sad-zz/Intelligent-Vehicle-Traffic-Monitoring-System/راهنمای ترددشمار مرداد 97.pdf

## دستورالعمل بهرهبرداري و پشتيباني

## از دستگاههاي ترددشمار رهسام

رهرو سامانه آسيا

تابستان 1397

سلام

همكار گرامي، دستورالعمل پيش رو، جهت پشتيباني از دستگاههاي ترددشمار تنظيم شده است. پس از مطالعه

دقيق اين دستورالعمل، شما ميتوانيد مشكلات احتمالي سيستم ترددشماري را - در صورتيكه مشكل داخلي

دستگاه وجود نداشته باشد- تشخيص داده و برطرف نماييد. همچنين ميتوانيد جهت بازديد و شمارش بصري

ترددشمار حضور پيدا كرده و شمارش بصري را انجام دهيد.

در صورتيكه پس از بازديد دستگاه، كليه موارد مطروحه در اين دفترچه را بررسي نموده و مشكل را تشخيص نداديد، ميتوانيد با شماره تلفن 09123701598 آقاي مهندس جليلوند تماس بگيريد.

پيش از شروع كار، لطفا به اين نكات توجه داشته باشيد.

-1 حتما پس از بازديد از هر دستگاه، گزارش كامل عملكرد خود و نتيجه را به صورت كتبي يا شفاهي با شركت در ميان بگذاريد.
-2 حتما به نكات و هشدارهاي تأكيد شده در اين دستورالعمل دقت كنيد و در صورتيكه در مورد موضوعي

ترديد داريد، به صورت تلفني مسئله را با آقاي مهندس جليلوند مطرح كنيد. مسئوليت دستگاه در حين

بازديد و سركشي به عهده شماست. در صورتيكه به علت عدم توجه به نكات اين دستورالعمل مشكلي براي سيستم به وجود بيايد، مسئوليت كامل مشكل به عهده شما خواهد بود. -3 از رانندگي هنگام خواب آلودگي و خستگي جدا پرهيز نماييد و با احتياط و ايمني كامل برانيد.

پيشاپيش از زحمات شما سپاسگزاريم.

معرفي دستگاه ترددشمار رهسام

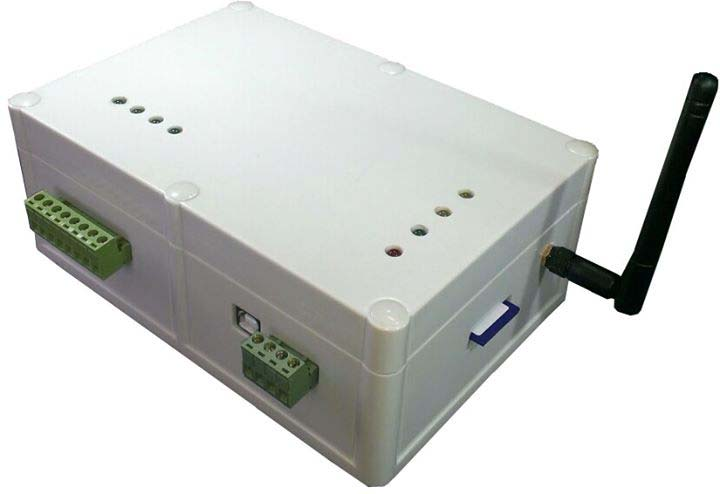
[picture p1: figure]

دستگاه ترددشمار رهسام به صورت يكپارچه (one in all (به توليد ميرسد كه يك دستگاه شامل سنسورهاي

اندازهگيري (آنالوگ و ديجيتال)، مودم و تجهيزات ارسال اطلاعات، كنترلر ولتاژ و... ميباشد.

هر دستگاه با يك شماره سريال 8 رقمي و يك عدد 3 رقمي براي نوع دستگاه مشخص ميگردد. مانند 10000052 براي سريال و 473 براي نوع دستگاه.

كد سريال روي دستگاه و كد نوع پشت دستگاه مشخص ميشود.

برچسب گارانتي رهسام (نقرهاي رنگ) به هيچ عنوان نبايد مخدوش شود!

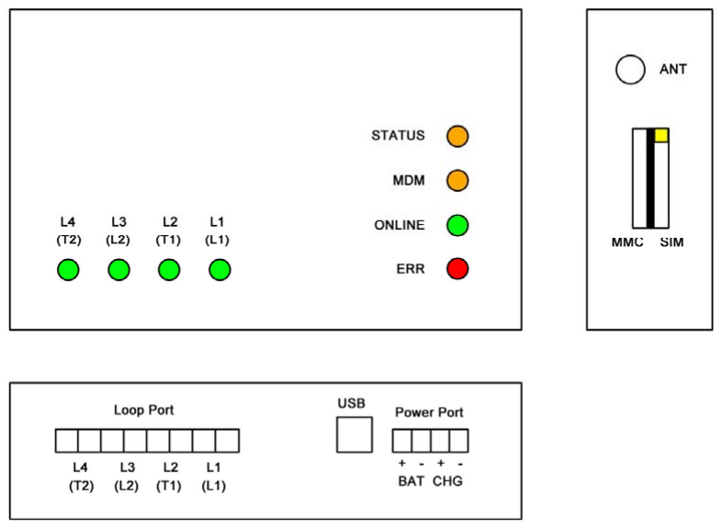
[picture p2: figure]

هر دستگاه از چهار حلقهي القايي (لوپ سنسور) و در نتيجه دو خط عبوري پشتيباني ميكند. دستگاه به صورت كلي شامل:

(Loop Port) | لوپها | پورت | •
(Power Port) | تغذيه | پورت | •
- پورت اتصال به كامپيوتر (USB(
- پورت آنتن (ANT(
- سوكت كارت حافظه (Card Memory(
- سوكت سيم كارت
LED | چراغهاي | •

ميباشد.

- پورت لوپها (Port Loop(: توسط يك سوكت فونيكس 8 پين، اتصال سيم لوپها به دستگاه برقرار

ميشود. به كمك سوكت فونيكس جهت تعويض دستگاه نيازي به باز كردن سيمها نيست و سوكت به صورت فشاري و كششي جدا ميشود. جهت اتصال سيمها به فونيكس، به يك پيچگوشتي دو سو ريز نياز است.

سيمهاي ورودي به سوكت فونيكس لوپها به اين ترتيب است:

از راست به چپ: لوپ 1 (1L – (لوپ 2 (1T – (لوپ 3 (2L – (لوپ 4 (2T (

- پورت تغذيه (Port Power(: منبع تغذيه، توسط يك سوكت فونيكس 4 پين به دستگاه متصل

ميشود.

سيمهاي ورودي به سوكت فونيكس تغذيه از راست به چپ به اين ترتيب است:

منفي شارژر – مثبت شارژر – منفي باتري – مثبت باتري

ورودي پورت تغذيه در برابر اتصال اشتباه حفاظت نشده است. قبل از اتصال فونيكس به دستگاه، حتما از صحت سيمهاي ورودي مطمئن شويد!

- پورت اتصال به كامپيوتر (USB(: از پورت USB جهت مشاهدهي عملكرد دستگاه (شمارش بصري)

و اعمال و تغيير تنظيمات استفاده ميگردد. بدين منظور به يك كابل USB نوع B) اصطلاحا كابل

پرينتر) نياز است. نحوهي كار با نرمافزار و كدهاي دستوري مورد استفاده در بخش مربوط توضيح داده شده است.
- پورت آنتن (ANT(: آنتن مودم داخلي دستگاه توسط سوكت Ω 50SMA به دستگاه متصل ميشود.

در برخي از سايتهاي ترددشماري، احتمالا نياز به رابط افزايش طول آنتن (كانكتور آنتن) جهت بهبود آنتندهي ميباشد.
- سوكت كارت حافظه (Card Memory(: جهت ذخيرهي كليهي اطلاعات عبوري از جمله اطلاعات

تجمعي و تك به تك خودروها، يك مموري كارت با فرمت 32FAT استفاده شده است. ظرفيت اين كارت حداكثر GB32 ميباشد و بايستي قبل از اتصال به دستگاه، آماده (فولدر بندي) شده باشد.

- سوكت سيمكارت: سيمكارت در داخل يك قطعه پلاستيكي (خشاب سيم كارت) قرار گرفته و به

صورت كشويي داخل سوكت قرار ميگيرد. پين كد سيمكارت قبل از قرار دادن در دستگاه بايستي غير فعال گردد.

مطمئن شويد خشاب سيمكارت در شيارهاي كناري به درستي قرار گرفته باشد. در غير اينصورت احتمال افتادن سيمكارت و خشاب به داخل دستگاه وجود دارد!

- چراغهاي LED: 8 عدد چراغ ال اي دي داخل دستگاه تعبيه گشته كه چهار عدد مربوط به عملكرد

لوپها (تريگر) و چهار عدد نشاندهندهي وضعيت عملكرد دستگاه ميباشد. در بخش عيبيابي، روشهاي عيب يابي هر قسمت به طور تفصيلي توضيح داده شده است.
a. چراغ 1L تا 4L: در صورت حضور خودرو روي هر لوپ، چراغ مربوط به لوپ روشن شده و در

صورت عدم حضور خودرو خاموش ميشود. در غير اينصورت عملكرد لوپها، سيمهاي ارتباطي
و يا دستگاه مشكل دارد.
b. چراغ STATUS: زماني كه دستگاه روشن ميشود حدود 4 ثانيه روشن شده و پس از آن يك ثانيه روشن – يك ثانيه خاموش ميباشد. در غير اينصورت عملكرد دستگاه مشكل دارد.
c. چراغ MDM: اين چراغ نمايشگر وضعيت مودم است. هنگام روشن شدن شدن دستگاه، پس

از چند ثانيه روشن شده، هنگام رجيستر شدن سيمكارت به صورت 800 ميلي ثانيه خاموش و 64 ميلي ثانيه روشن (چشمك سريع)؛ و هنگام عملكرد عادي حدود 3 ثانيه خاموش 64 ميلي ثانيه روشن (چشمك آرام) ميشود. در غير اينصورت، وضعيت آنتندهي، سيمكارت و يا

عملكرد دستگاه مشكل دارد.
d. چراغ ONLINE: هنگامي كه دستگاه به سرور متصل باشد روشن، و در غير اينصورت خاموش

است. معمولا حدود 15 تا 20 ثانيه بعد از شروع چشمك آرام، بايستي روشن شود و خاموشي

چراغ نبايد بيشتر از 1 دقيقه باشد.
e. چراغ ERR: در صورتيكه مموري كارت مشكل داشته باشد، يك ثانيه روشن و يك ثانيه

خاموش است و در عملكرد عادي دستگاه، بايستي دائم خاموش باشد.

راهنماي راهاندازي و تعمير دستگاه

قبل از هرگونه تغيير در سختافزار (برق، سيمكارت، كارت حافظه، لوپها و... حتما برق دستگاه را قطع كنيد!

.1 نحوهي اتصال تغذيه

دستگاه ترددشمار رهسام از چهار حالت منبع تغذيه پشتيباني ميكند:

- پنلهاي خورشيدي: در اين حالت، دو سيم سلول خورشيدي به شارژر و دو سيم باتري به قسمت

باتري متصل ميگردد.

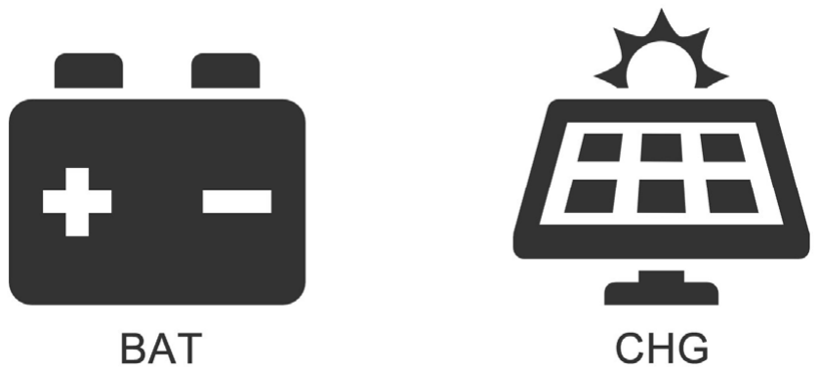
[picture p3: figure]

- برق شبانه (روشنايي جادهاي): در اين حالت، دو سيم آداپتور 24 ولت به قسمت شارژر و دو سيم

باتري به قسمت باتري متصل ميگردد.

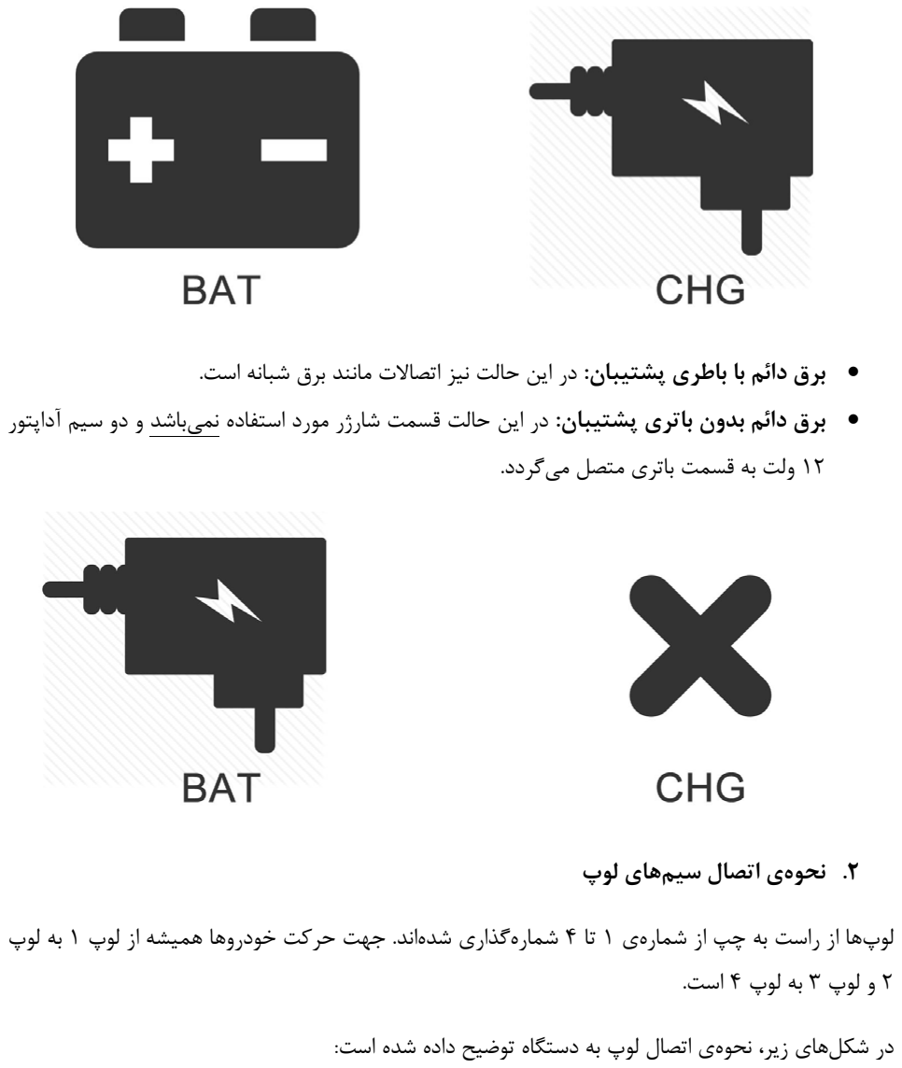
[picture p4: page 8]

- برق دائم با باطري پشتيبان: در اين حالت نيز اتصالات مانند برق شبانه است.
- برق دائم بدون باتري پشتيبان: در اين حالت قسمت شارژر مورد استفاده نميباشد و دو سيم آداپتور

12 ولت به قسمت باتري متصل ميگردد.

.2 نحوهي اتصال سيمهاي لوپ

لوپها از راست به چپ از شمارهي 1 تا 4 شمارهگذاري شدهاند. جهت حركت خودروها هميشه از لوپ 1 به لوپ 2 و لوپ 3 به لوپ 4 است.

در شكلهاي زير، نحوهي اتصال لوپ به دستگاه توضيح داده شده است:

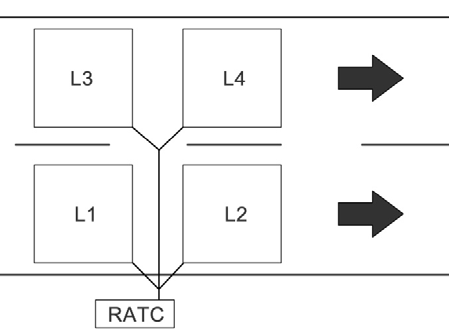
[picture p5: figure]
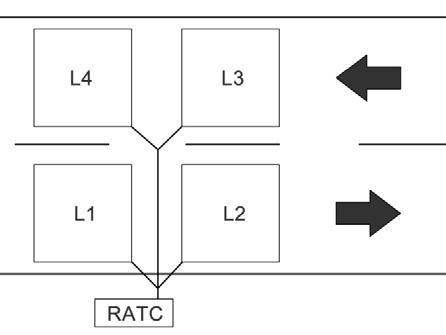
[picture p6: figure]

.3 نحوهي تعويض مموري كارت و استخراج اطلاعات آفلاين

سوكت مموري كارت، به صورت فشاري – دكمهاي است؛ هنگاميكه به داخل فشار داده شده و رها شود بيرون

ميآيد و براي جا زدن نيز هنگامي كه تا انتها وارد شده و آزاد شود، قفل ميگردد.

در داخل مموري كارت دو پوشه (فولدر) INT و TS بايد موجود باشد و داخل هر پوشه، دوازده پوشه به نامهاي 01 تا 12 تعبيه شده است.

جهت استخراج فايلهاي آفلاين كليه اطلاعات داخل مموري كارت را در كامپيوتر در يك پوشه به نام محور دستگاه (براي مثال karaj‐Tehran (كپي كرده و مموري كارت را در جاي خود قرار دهيد.

.4 نحوهي تعويض سيمكارت

خشاب سيمكارت، با فشار كليد زرد رنگ كنار سوكت از سوكت خارج ميشود. سيمكارت را از خشاب خارج كنيد و سيمكارت جديد را به خوبي داخل خشاب قرار دهيد، به طوريكه كاملا با لبههاي خشاب هم سطح شود.

سپس هنگام قراردادن خشاب داخل سوكت دقت كنيد لبههاي خشاب به درستي در شيارهاي سوكت قرار بگيرند. در غير اين صورت احتمال افتادن سيم كارت و خشاب به داخل دستگاه وجود دارد.

.5 نحوهي تعويض آنتن

آنتن و كانكتور آنتن، به صورت پيچي به دستگاه متصل ميشود. سفت كردن پيچهاي آنتن و كانكتور با دست كافيست و نيازي به استفاده از آچار، دم باريك و ... نميباشد.

.6 نحوهي تست اهمي لوپها

هر لوپ شامل دو سيم است و در هر سايت به تعداد چهار برابر خطوط عبوري سيم وجود دارد كه دو به دو به يكديگر اتصال دارند.

مقاومت اتصال دو سيم لوپ به يكديگر از كنار آسفالت تا ورود به دستگاه هيچگاه نبايد از 30 اهم بيشتر شود و

بوق اهممتر، بايد يكسره وصل باشد.

همچنين مقاومت بين سيمهاي لوپهاي مجزا، از كنار آسفالت تا ورود به دستگاه هيچگاه نبايد از 1 كيلو اهم

كمتر باشد.

اتصال به كامپيوتر

هيچ كدي را بدون هماهنگي وارد دستگاه نكنيد!

ابتدا درايورهاي مربوط به USB را (exe.Certified WHQL 2.12.04 v CDM (به روي سيستم نصب نماييد. سپس با اتصال كابل USB، سيستم به صورت خودكار شروع به نصب درايورهاي دستگاه مينمايد.

پس از اتمام نصب درايورها، يك پورت COM ايجاد ميشود كه از طريق اين پورت ميتوان به دستگاه متصل

شد.

نرمافزار پيشنهادي براي ارتباط با پورت COM، Terminal Hyper است؛ با شروع نرم افزار، يك نام دلخواه در نظر گرفته و سپس OK كنيد.

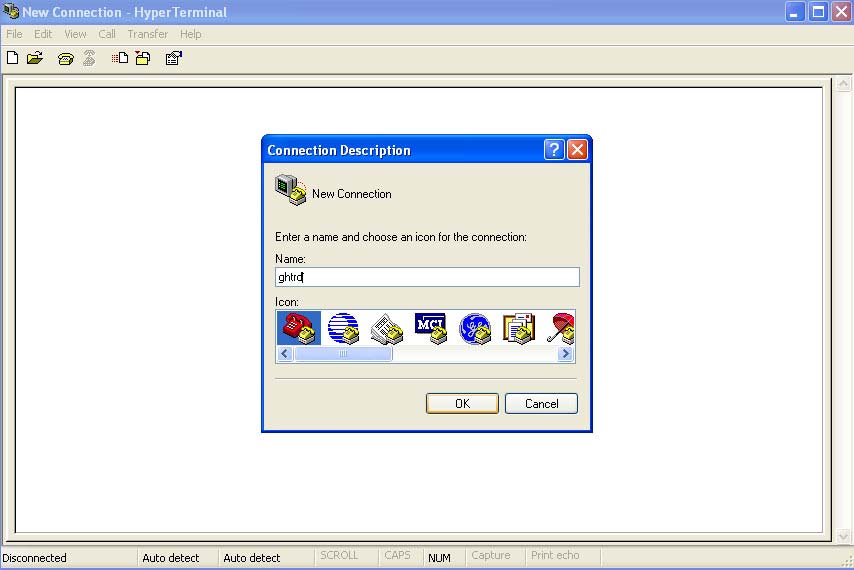
[picture p7: figure]

سپس آخرين COM نصب شده را انتخاب نماييد (در تصوير زير 43COM ميباشد. همچنين ميتوان از قسمت
COM نام از تا | گشت | USB Serial Port | دنبال | به Device Manager ‐> Ports (COM & LPT)

مطمئن شد.

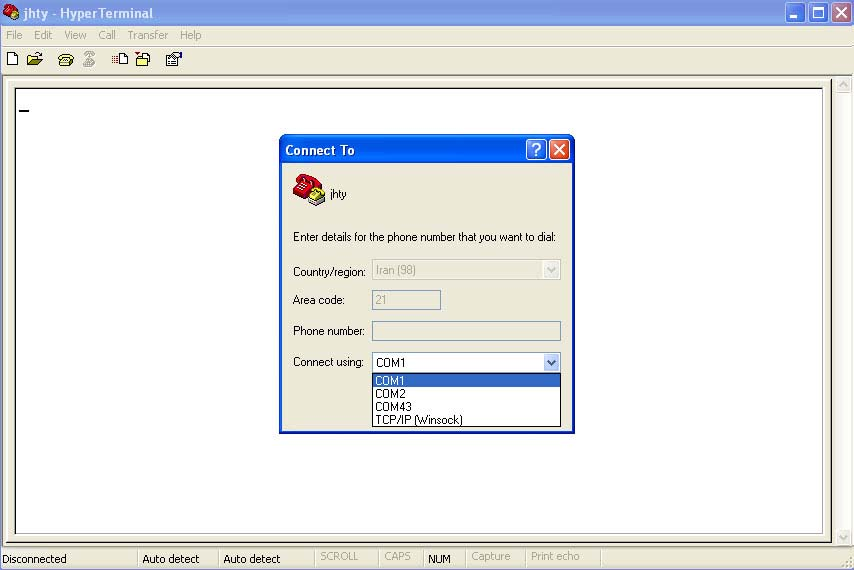
[picture p8: figure]

سپس تنظيمات زير را در پنجره اعمال كنيد:

Bits per second: 115200

Data bits: 8

Parity: None

Stop bits: 1

Flow control: None
و OK ) | کنید. اکنون ارتباط برقرار است با هربار فشردن کلید enter، تاریخ و ساعت دستگاه نمایش داده

ميشود).

با عبور هر خودرو، يك خط اطلاعات نمايش داده ميشود مانند:

15.08.08,16:54:31.4,2,E,050,000, 1648

:15.08.08,16:54:31.4 اطلاعات به ترتيب تاريخ و ساعت (سال، ماه، روز، ساعت، دقيقه، ثانيه و دهم ثانيه)

ميباشد.

:2 شمارهي خط عبوري (خودرو از لوپهاي 3L و 4L عبور كرده است).

E: كلاس خودرو (A: سواري و وانت، B: مينيبوس و كاميونت، C: كاميون، D: اتوبوس، E: تريلي و X: عدم

كلاسبندي)

:050 سرعت خودرو

:000 به ترتيب نشانگر تخلفات سرعت، سبقت و فاصله است. در صورت بروز هر كدام از تخلفات 1 ميشود (براي مثال 110 تخلف سرعت و سبقت، 001 تخلف فاصلهي طولي و...).

:1648 طول مغناطيسي خودرو (فقط براي آپديت نرمافزاري بكار ميآيد و كاربرد ديگري ندارد).

مشاهده تنظيمات

:0088 مشاهدهي تنظيمات

براي مشاهده تنظيمات كد (enter(0088 را وارد كنيد. چنين صفحهاي (مقادير ممكن است متفاوت باشد)

مشاهده ميكنيد:

0088
AUTCAL: 1
HMM: 10
X: 200
A: 510
B: 700
C: 1050
D: 1400
E: 2100
Margin: 15 5
APN: 1

LoopLen: 200
LoopWdt: 140
Speed: 95 85
Err: | | 1 1
Power: | 3
Name: 00000000000000000000000000000000 SMS: 09123701598
RATCX1
HW:A‐02,SW:H‐03
By Ali Jalilvand
OK
به | نيازي | و | هستند | سيستمي | پارامترهاي | Margin و E ،D ،C ،B ،A ،X ،HMM ،AUTCAL | پارامترهاي

تنظيم در سايت ندارند.

APN: نشاندهندهي نوع سيمكارت استفاده شده است. (0 ايرانسل، 1 همراه اول، 2 رايتل)

LoopLen: فاصلهي ابتداي لوپها در يك مسير بر حسب سانتي متر است. براي مثال اگر ابعاد لوپها 2.5*2.5 متر و با فاصلهي 1.5 متر باشد، عدد LoopLen برابر 4 متر يا 400 بايد باشد.

LoopWdt: نشاندهندهي طول لوپ (شروع تا پايان يك لوپ) بر حسب سانتي متر است. در مثال قبلي برابر 250 بايد باشد.

Speed: حاوي دو عدد است، عدد اول حداكثر سرعت مجاز روز و عدد دوم حداكثر سرعت مجاز شب.

ERR: در كاركرد نرمال دستگاه هر دو عدد بايد 0 باشند.

Power: نشاندهندهي نوع منبع تغذيه است، (0 سولار، 1 برق شبانه، 2 برق دائم با باتري پشتيبان و 3 برق

دائم بدون باتري پشتيبان).

Name: نام دستگاه ميباشد، براي مثال: 1Karaj‐Tehran

SMS: شمارهي ارسال اشكالات دستگاه است.
