sad-zz/Intelligent-Vehicle-Traffic-Monitoring-System/HARDWARE_WIRING_GUIDE.md

# راهنمای کامل اتصالات سخت‌افزاری

## نمای کلی

این راهنما شامل تمام اطلاعات لازم برای اتصال قطعات سخت‌افزاری به برد **EWB-STM32F407V-LAN-V4.0** است.

---

## قطعات مورد نیاز

### قطعات اصلی

| ردیف | قطعه | مدل/مشخصات | تعداد | قیمت تقریبی |
|---|---|---|---|---|
| 1 | برد STM32F407 | EWB-STM32F407V-LAN-V4.0 | 1 | $25 |
| 2 | ماژول GSM/GPRS | SIM800L | 1 | $5 |
| 3 | سنسور دما/رطوبت | DHT22 (یا SHT30) | 1 | $3 |
| 4 | سنسورهای القایی | Inductive Loop Sensors | 4 | $100-200 |
| 5 | Multiplexer | CD4052 (Dual 4-to-1) | 1 | $1 |
| 6 | SD Card | MicroSD 32GB Class 10 | 1 | $10 |
| 7 | منبع تغذیه | 12V 3A | 1 | $8 |
| 8 | باتری | 12V 7Ah Lead-Acid | 1 | $20 |
| 9 | پنل خورشیدی | 20W 12V | 1 | $25 |
| 10 | ماژول شارژ | Solar Charge Controller 12V | 1 | $10 |

### قطعات جانبی

| ردیف | قطعه | مقدار | تعداد |
|---|---|---|---|
| 1 | مقاومت 10KΩ | 1/4W | 10 |
| 2 | مقاومت 4.7KΩ | 1/4W | 2 |
| 3 | خازن 1000µF 25V | Electrolytic | 2 |
| 4 | خازن 100nF | Ceramic | 10 |
| 5 | دیود 1N5822 | Schottky | 2 |
| 6 | فیوز 2A | Glass | 2 |
| 7 | رگولاتور 5V | LM7805 + هیت‌سینک | 1 |
| 8 | رگولاتور 3.3V | AMS1117-3.3 | 1 |
| 9 | LED (قرمز/سبز) | 5mm | 4 |
| 10 | ترمینال پیچی | 2-Pin | 10 |

### کابل و سیم

| ردیف | نوع | طول | تعداد |
|---|-----|---|---|
| 1 | کابل USB Micro | 1m | 2 |
| 2 | سیم دوبل 0.5mm² | 10m | 1 |
| 3 | سیم تک 0.75mm² | 5m (هر رنگ) | 4 |
| 4 | کابل Ethernet CAT5e | 2m | 1 |
| 5 | کانکتور Dupont 2.54mm | Female-Female | 50 |

---

## بخش 1: اتصال برق

### 1.1 نمودار بلوکی سیستم برق

```
┌─────────────────┐
│  Solar Panel    │
│    20W 12V      │
└────────┬────────┘
         │
         ▼
┌─────────────────────┐
│ Charge Controller   │
│   12V 10A PWM       │
└──────┬──────────────┘
       │
       ▼
┌─────────────────┐    ┌──────────────────┐
│  Battery        │◄───│  Fuse 2A         │
│  12V 7Ah        │    └──────────────────┘
└────────┬────────┘
         │
         ├────────────────┐
         │                │
         ▼                ▼
    ┌────────┐      ┌──────────┐
    │  5V    │      │  3.3V    │
    │ Reg.   │      │  Reg.    │
    │LM7805  │      │AMS1117   │
    └───┬────┘      └─────┬────┘
        │                 │
        ▼                 ▼
   ┌─────────┐      ┌──────────┐
   │SIM800L  │      │ STM32    │
   │   5V    │      │  3.3V    │
   └─────────┘      └──────────┘
```

### 1.2 اتصالات تغذیه

#### پنل خورشیدی → Charge Controller
```
Panel (+)  →  Controller Solar(+)
Panel (-)  →  Controller Solar(-)
```

#### Charge Controller → باتری
```
Controller Battery(+)  →  Battery (+)  [با فیوز 2A]
Controller Battery(-)  →  Battery (-)
```

#### باتری → رگولاتورها
```
Battery (+) ──┬──→ LM7805 Input  →  LM7805 Output  →  SIM800L VCC (5V)
              │
              └──→ AMS1117 Input →  AMS1117 Output →  STM32 VCC (3.3V)

Battery (-) ──┴──→ GND Common
```

**مدار رگولاتور 5V (LM7805):**
```
12V ──[Diode]──┬──[LM7805]──┬──[Diode]── 5V Out
               │    IN OUT  │
             [1000µF]      [100nF]
               │            │
              GND          GND
```

**نکات مهم:**
- ✅ حتماً از هیت‌سینک برای LM7805 استفاده کنید
- ✅ خازن 1000µF روی ورودی و خروجی
- ✅ فیوز 2A برای محافظت
- ✅ دیود محافظ برای جلوگیری از برگشت جریان

---

## بخش 2: اتصال SIM800L

### 2.1 نقشه پین‌های SIM800L

```
SIM800L Module:
┌─────────────────┐
│  ○ RST          │  Reset (اختیاری)
│  ○ RXD          │  UART RX (به TX برد)
│  ○ TXD          │  UART TX (به RX برد)
│  ○ GND          │  زمین
│  ○ VCC          │  5V (2A)
│  ○ STATUS       │  وضعیت (اختیاری)
└─────────────────┘
```

### 2.2 اتصالات SIM800L به STM32

| SIM800L Pin | STM32 Pin | شماره پین | توضیحات |
|---|---|---|---|
| VCC | 5V (از رگولاتور) | - | **حداقل 2A** |
| GND | GND | - | زمین مشترک |
| TXD | PA3 (UART2_RX) | 18 | داده از ماژول |
| RXD | PA2 (UART2_TX) | 25 | داده به ماژول |
| RST | PB7 | 93 | Reset (اختیاری) |
| STATUS | PB6 | 92 | وضعیت ماژول |

**نمودار اتصال:**
```
STM32F407                      SIM800L
┌──────────┐                  ┌──────────┐
│          │                  │          │
│ PA2 (TX) ├─────────────────→│ RXD      │
│          │                  │          │
│ PA3 (RX) │←─────────────────┤ TXD      │
│          │                  │          │
│ PB7      ├─────────────────→│ RST      │
│          │                  │          │
│ PB6      │←─────────────────┤ STATUS   │
│          │                  │          │
│ GND      ├──────────────────┤ GND      │
│          │                  │          │
└──────────┘                  │ VCC      │
                              └────┬─────┘
                                   │
                              ┌────▼─────┐
                              │   5V     │
                              │ 2A Min   │
                              │ + 1000µF │
                              └──────────┘
```

**نکات مهم:**
- ⚠️ **خیلی مهم:** SIM800L نیاز به جریان بالا دارد (peak 2A)
- ✅ حتماً خازن 1000µF نزدیک VCC ماژول
- ✅ از منبع تغذیه مجزا استفاده کنید (نه از برد STM32)
- ✅ سیم‌های اتصال را کوتاه نگه دارید
- ✅ سیم‌کارت را قبل از روشن کردن وارد کنید

---

## بخش 3: اتصال سنسورهای القایی

### 3.1 معرفی Multiplexer

برای خواندن 4 سنسور از یک پین Input Capture، از یک **CD4052** (Dual 4-to-1 Mux) استفاده می‌کنیم.

**CD4052 Pinout:**
```
        ┌────────────┐
 X0  1 ─┤            ├─ 16  VDD (3.3V)
 X1  2 ─┤            ├─ 15  Y0
 Y1  3 ─┤            ├─ 14  X
 Y   4 ─┤  CD4052    ├─ 13  X2
 Y2  5 ─┤            ├─ 12  X3
 Y3  6 ─┤            ├─ 11  INH (GND)
VSS 7 ─┤            ├─ 10  B (SEL1)
 A  8 ─┤            ├─  9  A (SEL0)
        └────────────┘
```

### 3.2 اتصال Multiplexer

| CD4052 Pin | اتصال به |
|---|---|
| VDD (16) | 3.3V |
| VSS (7) | GND |
| INH (11) | GND |
| A (9) | PD0 (LOOP_SEL0) |
| B (10) | PD1 (LOOP_SEL1) |
| X (14) | PA0 (TIM2_CH1) |
| X0 (1) | Sensor 0 Output |
| X1 (2) | Sensor 1 Output |
| X2 (13) | Sensor 2 Output |
| X3 (12) | Sensor 3 Output |

### 3.3 نمودار اتصال کامل سنسورها

```
Inductive Loop Sensors (فرکانس 50-200kHz)
┌──────────┐  ┌──────────┐  ┌──────────┐  ┌──────────┐
│ Sensor 0 │  │ Sensor 1 │  │ Sensor 2 │  │ Sensor 3 │
│ (Loop 0) │  │ (Loop 1) │  │ (Loop 2) │  │ (Loop 3) │
└────┬─────┘  └────┬─────┘  └────┬─────┘  └────┬─────┘
     │             │             │             │
     │ Freq        │ Freq        │ Freq        │ Freq
     │ Output      │ Output      │ Output      │ Output
     ▼             ▼             ▼             ▼
    X0            X1            X2            X3
     └─────────────┴─────────────┴──────────────┘
                        │
                   ┌────▼─────┐
                   │  CD4052  │
                   │   MUX    │
                   └────┬─────┘
                        │ X (Common)
                        │
                        ▼
                    ┌───────┐
                    │ PA0   │  STM32F407
                    │TIM2   │  (Input Capture)
                    │ CH1   │
                    └───────┘

Control Signals:
PD0 (SEL0) ──→ CD4052 Pin A
PD1 (SEL1) ──→ CD4052 Pin B

Selection Table:
SEL1 SEL0 | Selected
  0    0  | Sensor 0
  0    1  | Sensor 1
  1    0  | Sensor 2
  1    1  | Sensor 3
```

### 3.4 مدار کامل یک سنسور القایی

```
Loop Coil (در جاده)
      ↓
┌─────────────┐
│ Oscillator  │  (LC Circuit - فرکانس پایه)
│  (50kHz)    │
└─────┬───────┘
      │ Freq Output
      ▼
┌─────────────┐
│  Amplifier  │  (تقویت سیگنال)
│   (OpAmp)   │
└─────┬───────┘
      │
      ▼
┌─────────────┐
│ Comparator  │  (تبدیل به Square Wave)
│  (Schmitt)  │
└─────┬───────┘
      │
      ▼
  To Multiplexer
```

**نکات:**
- سنسورهای القایی معمولاً خروجی Square Wave دارند
- فرکانس تغییر می‌کند وقتی فلز (خودرو) نزدیک می‌شود
- از کابل شیلددار برای اتصال سنسورها استفاده کنید

---

## بخش 4: اتصال سنسور دما و رطوبت

### 4.1 DHT22 Pinout

```
DHT22 (4 پین):
┌─────────┐
│    1    │  VCC (3.3V)
│    2    │  DATA
│    3    │  NC (Not Connected)
│    4    │  GND
└─────────┘
```

### 4.2 اتصال DHT22

| DHT22 Pin | STM32 Pin | توضیحات |
|---|---|---|
| VCC (1) | 3.3V | منبع تغذیه |
| DATA (2) | PC0 | دیتا (با pull-up 10KΩ) |
| NC (3) | - | اتصال ندارد |
| GND (4) | GND | زمین |

**مدار اتصال:**
```
     3.3V
       │
       ├─── [10KΩ] ───┐
       │              │
┌──────▼──────┐       │
│   DHT22     │       │
│             │       │
│  VCC  DATA  │←──────┘
│   │    │    │
│   1    2  4 │
└───┬────┬────┬───┘
    │    │    │
   3.3V PC0  GND
         │
         └──→ STM32F407
```

**جایگزین: SHT30 (دقت بالاتر)**

برای دقت بهتر، می‌توانید از SHT30 استفاده کنید:

| SHT30 | STM32 |
|---|---|
| VCC | 3.3V |
| GND | GND |
| SDA | PB9 (I2C1_SDA) |
| SCL | PB8 (I2C1_SCL) |

---

## بخش 5: اتصال SD Card

### 5.1 SD Card بر روی برد

**خبر خوب:** برد EWB-STM32F407 دارای سوکت SD Card است که از طریق SDIO به STM32 متصل است.

**پین‌ها (خودکار متصل):**
- PC8 → SDIO_D0
- PC9 → SDIO_D1
- PC10 → SDIO_D2
- PC11 → SDIO_D3
- PC12 → SDIO_CLK
- PD2 → SDIO_CMD

**کاری لازم نیست** - فقط SD Card را در سوکت قرار دهید.

**توصیه:**
- از کارت Class 10 یا بالاتر استفاده کنید
- حداقل 8GB
- فرمت: FAT32

---

## بخش 6: اتصالات جانبی

### 6.1 LED وضعیت

**LED موجود روی برد:**
- PE4 → STATUS_LED (قرمز - موجود روی برد)

**LED اضافی (اختیاری):**
```
    3.3V
      │
  [510Ω]
      │
    [LED] (Green)
      │
      └──→ PB15 (خروجی)
```

### 6.2 دکمه Reset

**دکمه موجود روی برد:**
- RESET Button → NRST Pin

### 6.3 دکمه WAKEUP

**دکمه موجود روی برد:**
- WAKEUP Button → PA0 (با pull-down)

---

## بخش 7: اتصال به کامپیوتر

### 7.1 USB-Serial (CP2104)

**USB1 روی برد:**
- اتصال به کامپیوتر با کابل USB Micro
- پورت سریال: UART1 (PA9/PA10)
- سرعت: 115200 baud
- استفاده: Serial Console, Debug, Config

### 7.2 SWD Programming

**5-Pin SWD Header:**

| Pin | نام | رنگ سیم (استاندارد) |
|-----|-----|---|
| 1 | VCC | قرمز |
| 2 | SWDIO | سبز |
| 3 | GND | سیاه |
| 4 | SWCLK | آبی |
| 5 | NRST | زرد |

**اتصال ST-Link V2:**
```
ST-Link V2          STM32 Board
┌──────────┐        ┌──────────┐
│ 3.3V     ├───────→│ VCC      │
│ SWDIO    ├───────→│ SWDIO    │
│ GND      ├───────→│ GND      │
│ SWCLK    ├───────→│ SWCLK    │
│ RST      ├───────→│ NRST     │
└──────────┘        └──────────┘
```

---

## بخش 8: آزمایش اتصالات

### 8.1 Checklist قبل از روشن کردن

#### بررسی برق
- [ ] فیوزها در جای خود هستند
- [ ] قطبیت باتری صحیح است (+/-)
- [ ] رگولاتورها صحیح نصب شده‌اند
- [ ] خازن 1000µF روی SIM800L وجود دارد

#### بررسی اتصالات
- [ ] همه اتصالات GND مشترک هستند
- [ ] VCC و GND short ندارند (با مولتی‌متر)
- [ ] پین‌های UART صحیح متصل شده‌اند (TX→RX, RX→TX)

#### بررسی سنسورها
- [ ] سنسورها برق دارند
- [ ] خروجی سنسورها به Multiplexer متصل است
- [ ] پین‌های کنترل (PD0/PD1) صحیح است

### 8.2 تست گام به گام

**مرحله 1: تست منبع تغذیه**
```
1. فقط باتری و رگولاتور را وصل کنید
2. با مولتی‌متر:
   - خروجی 5V: 4.8-5.2V
   - خروجی 3.3V: 3.2-3.4V
3. اگر OK → ادامه دهید
```

**مرحله 2: تست STM32**
```
1. فقط STM32 را روشن کنید (بدون SIM800L)
2. LED روی برد باید چشمک بزند
3. اتصال USB-Serial
4. باز کردن Serial Console
   - اگر پیام welcome آمد → OK
```

**مرحله 3: تست سنسورها**
```
1. روشن کردن سنسورها
2. در Serial Console:
   > TEST SENSOR 0
   > TEST SENSOR 1
   > TEST SENSOR 2
   > TEST SENSOR 3
3. هر کدام باید فرکانس نشان دهند
```

**مرحله 4: تست SIM800L**
```
1. وارد کردن سیم‌کارت
2. اتصال SIM800L
3. روشن کردن
4. منتظر بمانید LED روی ماژول چشمک بزند (60 ثانیه)
5. در Serial Console:
   > TEST GPRS
6. باید "GPRS OK" نمایش دهد
```

**مرحله 5: تست DHT22**
```
1. در Serial Console:
   > STATUS
2. بررسی فیلدهای temperature و humidity
3. باید مقادیر واقعی نمایش دهد
```

---

## بخش 9: نصب فیزیکی در محل

### 9.1 انتخاب محل نصب

**ملاحظات:**
- ✅ نزدیک به محل نصب سنسورها (حداکثر 50 متر)
- ✅ در معرض نور خورشید (برای پنل)
- ✅ محافظت از باران و رطوبت
- ✅ دسترسی برای تعمیر و نگهداری
- ✅ سیگنال GSM قوی (> 15 dBm)

### 9.2 نصب سنسورهای القایی در جاده

**روش نصب loop ها:**

```
═══════════════════════ جاده ════════════════════════

        Lane 1                    Lane 2
    ┌──────────┐              ┌──────────┐
    │  Loop 0  │              │  Loop 2  │
    └──────────┘              └──────────┘
         ↑                         ↑
         │ 4m (loop_distance)      │
         ▼                         ▼
    ┌──────────┐              ┌──────────┐
    │  Loop 1  │              │  Loop 3  │
    └──────────┘              └──────────┘

Loop Size: 1.4m × 2m (width × length)
Depth: 3-5 cm in asphalt
Wire: 3-5 loops, AWG 14-18
```

**مراحل نصب:**
1. برش آسفالت (3-5 cm عمق)
2. قرار دادن سیم (3-5 دور)
3. اتصال به oscillator
4. پر کردن با چسب epoxy
5. تست با multimeter (اندوکتانس 50-200µH)

### 9.3 نصب جعبه تجهیزات

**محتویات جعبه:**
```
┌─────────────────────────────┐
│  ┌──────┐      ┌──────┐     │  Weatherproof Box
│  │Solar │      │Batt. │     │  (IP65 or higher)
│  │Chg.  │      │ 12V  │     │
│  └──────┘      └──────┘     │
│                              │
│  ┌────────────────────┐     │
│  │   STM32 Board      │     │
│  │   + SIM800L        │     │
│  └────────────────────┘     │
│                              │
│  ┌──────┐  ┌──────┐         │
│  │ 5V   │  │ 3.3V │         │
│  │ Reg. │  │ Reg. │         │
│  └──────┘  └──────┘         │
└─────────────────────────────┘
         ↑
    ┌────┴─────┐
    │  Cables  │
    │  Entry   │
    └──────────┘
```

**نکات:**
- استفاده از cable glands برای ورودی کابل‌ها
- سیلیکون برای waterproofing
- Desiccant برای جذب رطوبت
- فن کوچک برای خنک‌سازی (اختیاری)

---

## بخش 10: Troubleshooting سخت‌افزار

### مشکلات رایج

#### 1. برد روشن نمی‌شود
**علل محتمل:**
- قطبیت معکوس برق
- فیوز سوخته
- short circuit

**راه‌حل:**
```
1. قطع برق
2. بررسی ولتاژ باتری با مولتی‌متر
3. بررسی فیوزها
4. بررسی short با مولتی‌متر (Continuity Test)
```

#### 2. SIM800L روشن نمی‌شود
**علل:**
- جریان ناکافی
- سیم‌کارت غیرفعال

**راه‌حل:**
```
1. بررسی ولتاژ VCC (باید 4.8-5.2V باشد)
2. بررسی جریان منبع (حداقل 2A)
3. اضافه کردن خازن 1000µF
4. تست سیم‌کارت در موبایل
```

#### 3. سنسورها خوانده نمی‌شوند
**علل:**
- اتصال نادرست Multiplexer
- سنسور خراب
- کابل قطع

**راه‌حل:**
```
1. بررسی اتصالات با مولتی‌متر
2. تست خروجی سنسور با اسیلوسکوپ
3. بررسی پین‌های کنترل (PD0/PD1)
4. اجرای کالیبراسیون
```

---

## نمودار کامل سیستم

```
┌─────────────────────────────────────────────────────────────┐
│                     POWER SYSTEM                            │
│  ┌──────┐    ┌─────────┐    ┌───────┐    ┌──────────┐     │
│  │Solar │───→│ Charge  │───→│Battery│───→│Regulators│     │
│  │Panel │    │Controller│    │ 12V   │    │ 5V/3.3V  │     │
│  └──────┘    └─────────┘    └───────┘    └─────┬────┘     │
└─────────────────────────────────────────────────┼──────────┘
                                                  │
                  ┌───────────────────────────────┴─────────┐
                  │                                         │
                  ▼                                         ▼
┌──────────────────────────────┐         ┌──────────────────────────┐
│      STM32F407 BOARD         │         │       SIM800L            │
│                              │         │                          │
│  PA0 ← Sensors (via MUX)     │         │  TXD → PA3               │
│  PA2 → SIM800L RX            │         │  RXD ← PA2               │
│  PA3 ← SIM800L TX            │         │  VCC ← 5V (2A)           │
│  PD0,PD1 → MUX Control       │         │  STATUS → PB6            │
│  PC0 ↔ DHT22                 │         │  RST ← PB7               │
│  PC8-12,PD2 → SD Card        │         └──────────────────────────┘
│  PB8,PB9 → I2C (optional)    │
│  PA13,PA14 → SWD             │
│  PA9,PA10 → USB-Serial       │
└──────────────────────────────┘
         │
         ▼
┌──────────────────────────────┐
│     SENSOR MULTIPLEXER       │
│       (CD4052)               │
│                              │
│  X0 ← Sensor 0 (Loop 0)      │
│  X1 ← Sensor 1 (Loop 1)      │
│  X2 ← Sensor 2 (Loop 2)      │
│  X3 ← Sensor 3 (Loop 3)      │
│  X → PA0                     │
│  A,B ← PD0,PD1               │
└──────────────────────────────┘
```

---

## فایل‌های مرجع

- **Schematic:** `EWB-STM32F407-V4_schematic.pdf`
- **Firmware Guide:** `STM32_SETUP_GUIDE.md`
- **Server Guide:** `SERVER_HARDWARE_REQUIREMENTS.md`

---

**نکته نهایی:** همیشه قبل از اتصال برق، تمام اتصالات را با مولتی‌متر بررسی کنید!
