sad-zz/Intelligent-Vehicle-Traffic-Monitoring-System/EWB-STM32F407-V4_schematic.pdf

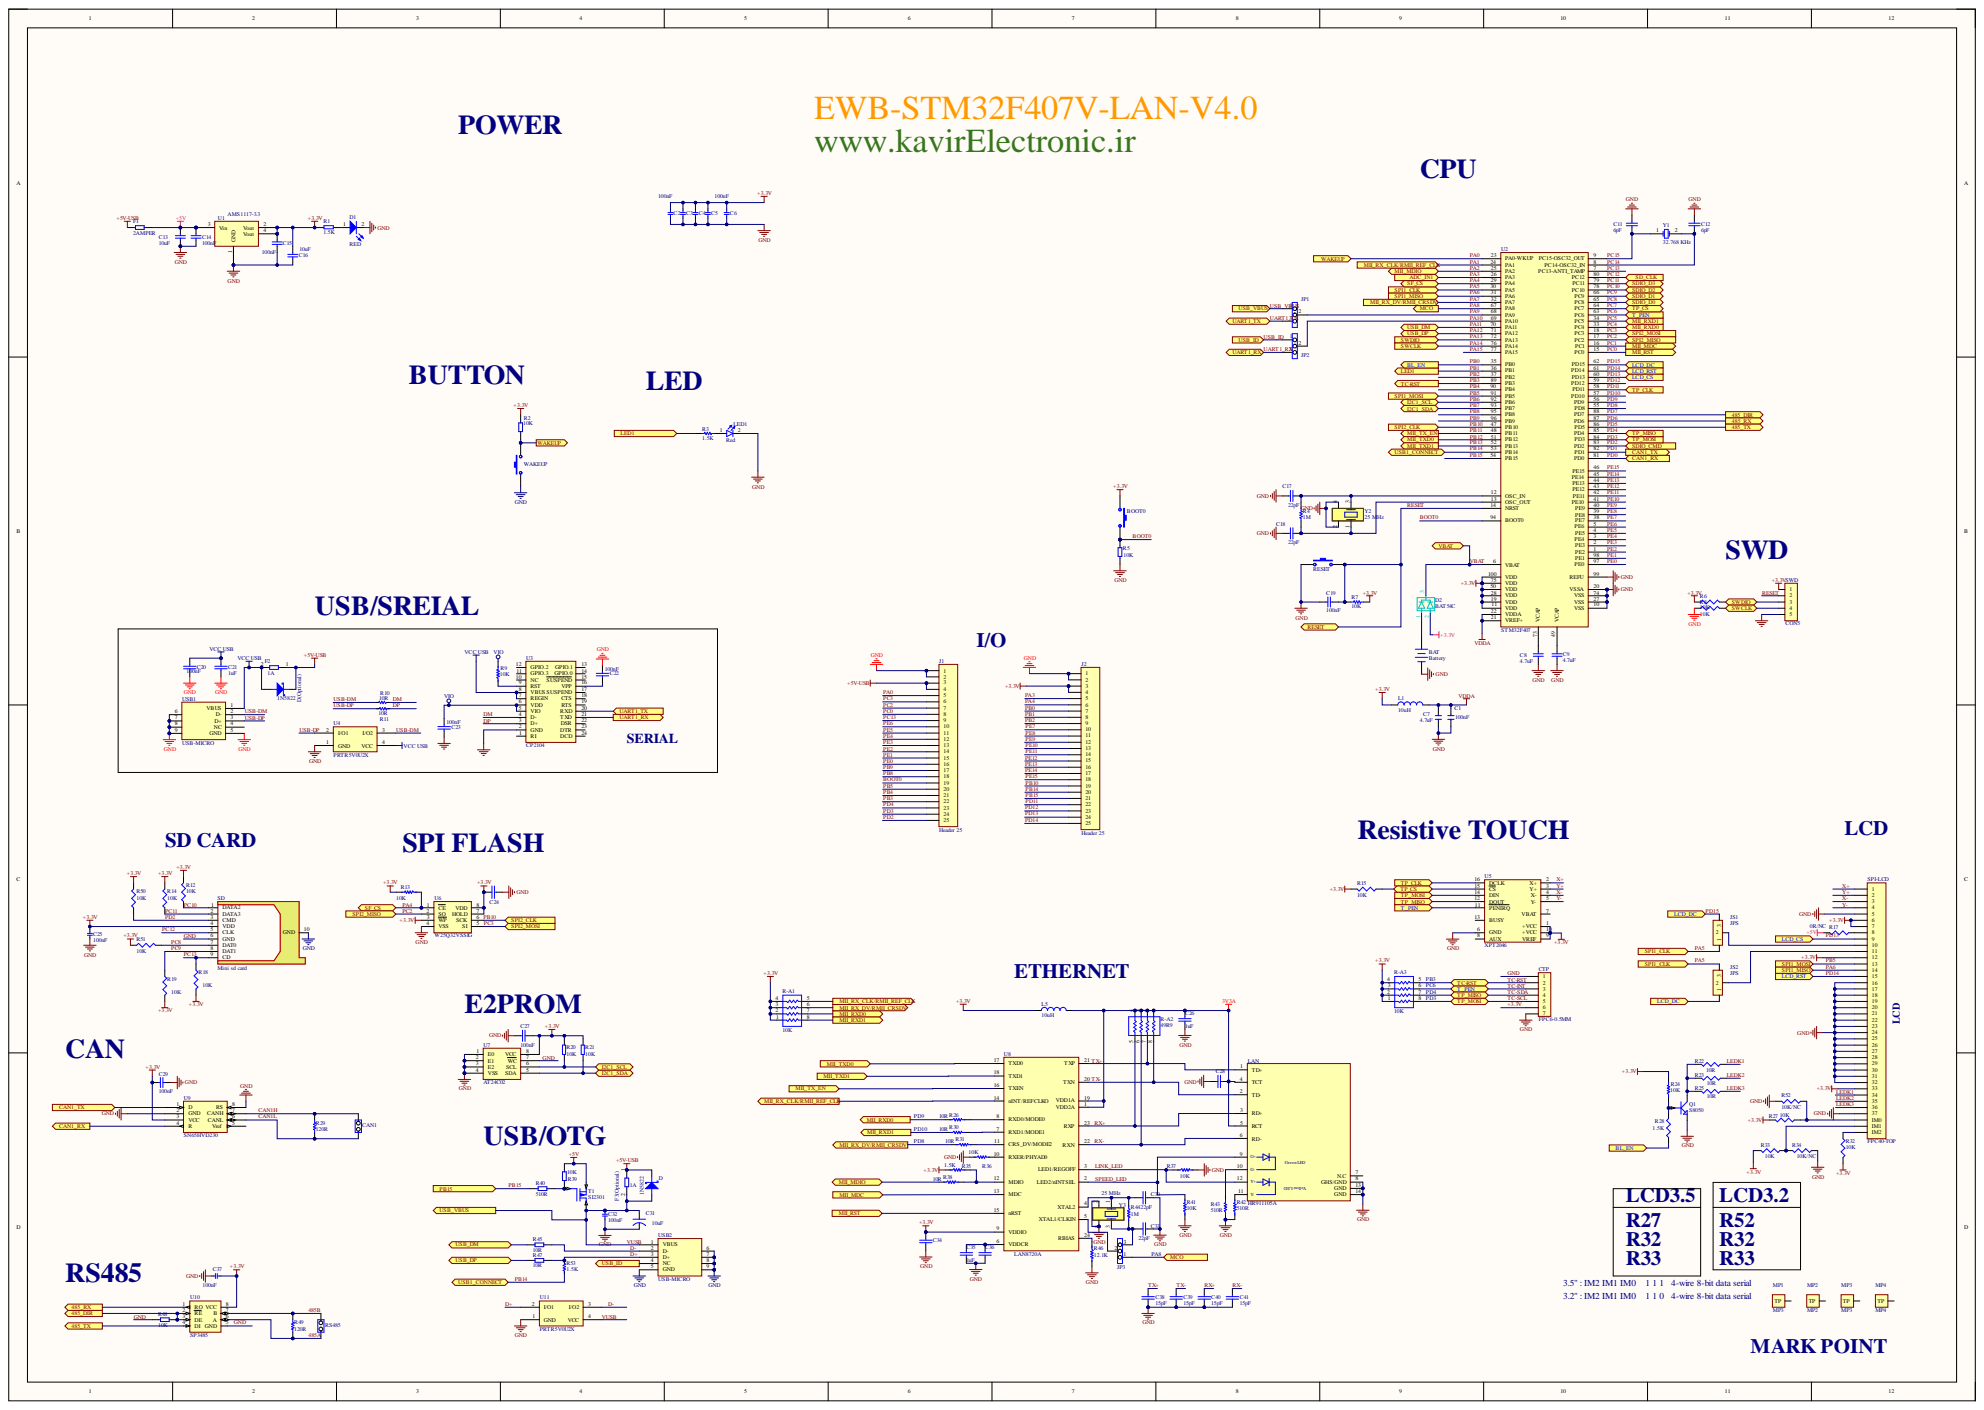
[picture p9: page 1]

Vout | 2 Vin 3 4

32.768 KHz

PA11 USB_DM PA12 USB_DP SWDIO | PA11 70 PA12 71

PD13 LCD_CS

GND 5 | 9

3.5" : IM2 IM1 IM0 1 1 1 4-wire 8-bit data serial
3.2" : IM2 IM1 IM0 1 1 0 4-wire 8-bit data serial
