sad-zz/Intelligent-Vehicle-Traffic-Monitoring-System/firmware_stm32/VehicleTrafficMonitor.ioc

Mcu.UserName=STM32F407VGTx
PA0-WKUP.Signal=S_TIM2_CH1_ETR
PA10.Signal=USART1_RX
PA13.Signal=SYS_JTMS-SWDIO
PA14.Signal=SYS_JTCK-SWCLK
PA2.Signal=USART2_TX
PA3.Signal=USART2_RX
PA4.Signal=ADCx_IN4
PA5.Signal=ADCx_IN5
PA8.GPIO_Label=MCO
PA8.Signal=RCC_MCO_1
PA9.Signal=USART1_TX
PB10.GPIO_Label=I2C1_SCL
PB10.Signal=I2C1_SCL
PB11.GPIO_Label=I2C1_SDA
PB11.Signal=I2C1_SDA
PB14.GPIO_Label=USB1_CONNECT
PB14.Signal=GPIO_Output
PB15.GPIO_Label=PB15
PB15.Signal=GPIO_Output
PB2.GPIO_Label=SIM800L_PWR
PB2.Signal=GPIO_Output
PB6.GPIO_Label=SIM800L_STATUS
PB6.Signal=GPIO_Input
PB7.GPIO_Label=SIM800L_PWRKEY
PB7.Signal=GPIO_Output
PB8.Signal=I2C1_SCL
PB9.Signal=I2C1_SDA
PC0.GPIO_Label=DHT22_DATA
PC0.Signal=GPIO_Input
PC10.Signal=SDIO_D2
PC11.Signal=SDIO_D3
PC12.Signal=SDIO_CK
PC13-ANTI_TAMP.GPIO_Label=WAKEUP
PC13-ANTI_TAMP.Signal=GPIO_Input
PC14-OSC32_IN.Signal=RCC_OSC32_IN
PC15-OSC32_OUT.Signal=RCC_OSC32_OUT
PC8.Signal=SDIO_D0
PC9.Signal=SDIO_D1
PD0.GPIO_Label=LOOP_SEL0
PD0.Signal=GPIO_Output
PD1.GPIO_Label=LOOP_SEL1
PD1.Signal=GPIO_Output
PD2.Signal=SDIO_CMD
PE0.Signal=GPIO_Input
PE1.Signal=GPIO_Input
PE10.Signal=GPIO_Input
PE11.Signal=GPIO_Input
PE12.Signal=GPIO_Input
PE13.Signal=GPIO_Input
PE14.Signal=GPIO_Input
PE15.Signal=GPIO_Input
PE2.Signal=GPIO_Input
PE3.Signal=GPIO_Input
PE4.GPIO_Label=STATUS_LED
PE4.Signal=GPIO_Output
PE5.Signal=GPIO_Input
PE6.Signal=GPIO_Input
PE7.Signal=GPIO_Input
PE8.Signal=GPIO_Input
PE9.Signal=GPIO_Input
PH0-OSC_IN.Signal=RCC_OSC_IN
PH1-OSC_OUT.Signal=RCC_OSC_OUT
