sad-zz/Intelligent-Vehicle-Traffic-Monitoring-System/firmware/Main/91-7.asm

_rtc_read:

;ds1305_lib.h,2 :: 		void rtc_read()
;ds1305_lib.h,4 :: 		shorttostr(current_time.year,tmp3);
	PUSH	W10
	PUSH	W11
	MOV	#lo_addr(_tmp3), W11
	MOV	#lo_addr(_current_time+6), W0
	MOV.B	[W0], W10
	CALL	_ShortToStr
;ds1305_lib.h,5 :: 		datetimesec[2]=tmp3[2];
	MOV	#lo_addr(_datetimesec+2), W1
	MOV	#lo_addr(_tmp3+2), W0
	MOV.B	[W0], [W1]
;ds1305_lib.h,6 :: 		datetimesec[3]=tmp3[3];
	MOV	#lo_addr(_datetimesec+3), W1
	MOV	#lo_addr(_tmp3+3), W0
	MOV.B	[W0], [W1]
;ds1305_lib.h,7 :: 		shorttostr(current_time.month,tmp3);
	MOV	#lo_addr(_tmp3), W11
	MOV	#lo_addr(_current_time+5), W0
	MOV.B	[W0], W10
	CALL	_ShortToStr
;ds1305_lib.h,8 :: 		datetimesec[5]=tmp3[2];
	MOV	#lo_addr(_datetimesec+5), W1
	MOV	#lo_addr(_tmp3+2), W0
	MOV.B	[W0], [W1]
;ds1305_lib.h,9 :: 		datetimesec[6]=tmp3[3];
	MOV	#lo_addr(_datetimesec+6), W1
	MOV	#lo_addr(_tmp3+3), W0
	MOV.B	[W0], [W1]
;ds1305_lib.h,10 :: 		shorttostr(current_time.day,tmp3);
	MOV	#lo_addr(_tmp3), W11
	MOV	#lo_addr(_current_time+4), W0
	MOV.B	[W0], W10
	CALL	_ShortToStr
;ds1305_lib.h,11 :: 		datetimesec[8]=tmp3[2];
	MOV	#lo_addr(_datetimesec+8), W1
	MOV	#lo_addr(_tmp3+2), W0
	MOV.B	[W0], [W1]
;ds1305_lib.h,12 :: 		datetimesec[9]=tmp3[3];
	MOV	#lo_addr(_datetimesec+9), W1
	MOV	#lo_addr(_tmp3+3), W0
	MOV.B	[W0], [W1]
;ds1305_lib.h,13 :: 		shorttostr(current_time.hour,tmp3);
	MOV	#lo_addr(_tmp3), W11
	MOV	#lo_addr(_current_time+3), W0
	MOV.B	[W0], W10
	CALL	_ShortToStr
;ds1305_lib.h,14 :: 		datetimesec[11]=tmp3[2];
	MOV	#lo_addr(_datetimesec+11), W1
	MOV	#lo_addr(_tmp3+2), W0
	MOV.B	[W0], [W1]
;ds1305_lib.h,15 :: 		datetimesec[12]=tmp3[3];
	MOV	#lo_addr(_datetimesec+12), W1
	MOV	#lo_addr(_tmp3+3), W0
	MOV.B	[W0], [W1]
;ds1305_lib.h,16 :: 		shorttostr(current_time.minute,tmp3);
	MOV	#lo_addr(_tmp3), W11
	MOV	#lo_addr(_current_time+2), W0
	MOV.B	[W0], W10
	CALL	_ShortToStr
;ds1305_lib.h,17 :: 		datetimesec[14]=tmp3[2];
	MOV	#lo_addr(_datetimesec+14), W1
	MOV	#lo_addr(_tmp3+2), W0
	MOV.B	[W0], [W1]
;ds1305_lib.h,18 :: 		datetimesec[15]=tmp3[3];
	MOV	#lo_addr(_datetimesec+15), W1
	MOV	#lo_addr(_tmp3+3), W0
	MOV.B	[W0], [W1]
;ds1305_lib.h,19 :: 		shorttostr(current_time.second,tmp3);
	MOV	#lo_addr(_tmp3), W11
	MOV	#lo_addr(_current_time+1), W0
	MOV.B	[W0], W10
	CALL	_ShortToStr
;ds1305_lib.h,20 :: 		datetimesec[17]=tmp3[2];
	MOV	#lo_addr(_datetimesec+17), W1
	MOV	#lo_addr(_tmp3+2), W0
	MOV.B	[W0], [W1]
;ds1305_lib.h,21 :: 		datetimesec[18]=tmp3[3];
	MOV	#lo_addr(_datetimesec+18), W1
	MOV	#lo_addr(_tmp3+3), W0
	MOV.B	[W0], [W1]
;ds1305_lib.h,22 :: 		datetimesec[20]=(char)((milisec/100)+48);
	MOV	#100, W2
	MOV	_milisec, W0
	REPEAT	#17
	DIV.S	W0, W2
	MOV	W0, W3
	MOV.B	#48, W1
	MOV	#lo_addr(_datetimesec+20), W0
	ADD.B	W3, W1, [W0]
	MOV	#lo_addr(_datetimesec+20), W1
	MOV	#lo_addr(_datetimesec+20), W0
	MOV.B	[W0], [W1]
;ds1305_lib.h,23 :: 		for(rtc_read_cnt=0;rtc_read_cnt<strlen(datetimesec);rtc_read_cnt++) if(datetimesec[rtc_read_cnt]==' ') datetimesec[rtc_read_cnt]='0';
	MOV	#lo_addr(_rtc_read_cnt), W1
	CLR	W0
	MOV.B	W0, [W1]
L_rtc_read0:
	MOV	#lo_addr(_datetimesec), W10
	CALL	_strlen
	MOV	#lo_addr(_rtc_read_cnt), W1
	SE	[W1], W1
	CP	W1, W0
	BRA LT	L__rtc_read1045
	GOTO	L_rtc_read1
L__rtc_read1045:
	MOV	#lo_addr(_rtc_read_cnt), W0
	SE	[W0], W1
	MOV	#lo_addr(_datetimesec), W0
	ADD	W0, W1, W0
	MOV.B	[W0], W1
	MOV.B	#32, W0
	CP.B	W1, W0
	BRA Z	L__rtc_read1046
	GOTO	L_rtc_read3
L__rtc_read1046:
	MOV	#lo_addr(_rtc_read_cnt), W0
	SE	[W0], W1
	MOV	#lo_addr(_datetimesec), W0
	ADD	W0, W1, W1
	MOV.B	#48, W0
	MOV.B	W0, [W1]
L_rtc_read3:
	MOV.B	#1, W1
	MOV	#lo_addr(_rtc_read_cnt), W0
	ADD.B	W1, [W0], [W0]
	GOTO	L_rtc_read0
L_rtc_read1:
;ds1305_lib.h,24 :: 		}
L_end_rtc_read:
	POP	W11
	POP	W10
	RETURN
; end of _rtc_read

_rtc_init:

;ds1305_lib.h,25 :: 		void rtc_init()
;ds1305_lib.h,27 :: 		current_time.second=0;
	MOV	#lo_addr(_current_time+1), W1
	CLR	W0
	MOV.B	W0, [W1]
;ds1305_lib.h,28 :: 		current_time.minute=0;
	MOV	#lo_addr(_current_time+2), W1
	CLR	W0
	MOV.B	W0, [W1]
;ds1305_lib.h,29 :: 		current_time.hour=0;
	MOV	#lo_addr(_current_time+3), W1
	CLR	W0
	MOV.B	W0, [W1]
;ds1305_lib.h,30 :: 		current_time.day=1;
	MOV	#lo_addr(_current_time+4), W1
	MOV.B	#1, W0
	MOV.B	W0, [W1]
;ds1305_lib.h,31 :: 		current_time.month=1;
	MOV	#lo_addr(_current_time+5), W1
	MOV.B	#1, W0
	MOV.B	W0, [W1]
;ds1305_lib.h,32 :: 		current_time.year=0;
	MOV	#lo_addr(_current_time+6), W1
	CLR	W0
	MOV.B	W0, [W1]
;ds1305_lib.h,39 :: 		}
L_end_rtc_init:
	RETURN
; end of _rtc_init

_rtc_write:

;ds1305_lib.h,40 :: 		void rtc_write(char input)
;ds1305_lib.h,47 :: 		rtc=1;
	BSET	LATF0_bit, BitPos(LATF0_bit+0)
;ds1305_lib.h,48 :: 		if(input==1)
	CP.B	W10, #1
	BRA Z	L__rtc_write1049
	GOTO	L_rtc_write4
L__rtc_write1049:
;ds1305_lib.h,50 :: 		current_time.second=(uart1_data[15]-48)+(uart1_data[14]-48)*10;
	MOV	#lo_addr(_uart1_data+15), W0
	ZE	[W0], W1
	MOV	#48, W0
	SUB	W1, W0, W2
	MOV	#lo_addr(_uart1_data+14), W0
	ZE	[W0], W1
	MOV	#48, W0
	SUB	W1, W0, W1
	MOV	#10, W0
	MUL.UU	W1, W0, W0
	ADD	W2, W0, W1
	MOV	#lo_addr(_current_time+1), W0
	MOV.B	W1, [W0]
;ds1305_lib.h,51 :: 		current_time.minute=(uart1_data[13]-48)+(uart1_data[12]-48)*10;
	MOV	#lo_addr(_uart1_data+13), W0
	ZE	[W0], W1
	MOV	#48, W0
	SUB	W1, W0, W2
	MOV	#lo_addr(_uart1_data+12), W0
	ZE	[W0], W1
	MOV	#48, W0
	SUB	W1, W0, W1
	MOV	#10, W0
	MUL.UU	W1, W0, W0
	ADD	W2, W0, W1
	MOV	#lo_addr(_current_time+2), W0
	MOV.B	W1, [W0]
;ds1305_lib.h,52 :: 		current_time.hour=(uart1_data[11]-48)+(uart1_data[10]-48)*10;
	MOV	#lo_addr(_uart1_data+11), W0
	ZE	[W0], W1
	MOV	#48, W0
	SUB	W1, W0, W2
	MOV	#lo_addr(_uart1_data+10), W0
	ZE	[W0], W1
	MOV	#48, W0
	SUB	W1, W0, W1
	MOV	#10, W0
	MUL.UU	W1, W0, W0
	ADD	W2, W0, W1
	MOV	#lo_addr(_current_time+3), W0
	MOV.B	W1, [W0]
;ds1305_lib.h,53 :: 		current_time.day=(uart1_data[9]-48)+(uart1_data[8]-48)*10;
	MOV	#lo_addr(_uart1_data+9), W0
	ZE	[W0], W1
	MOV	#48, W0
	SUB	W1, W0, W2
	MOV	#lo_addr(_uart1_data+8), W0
	ZE	[W0], W1
	MOV	#48, W0
	SUB	W1, W0, W1
	MOV	#10, W0
	MUL.UU	W1, W0, W0
	ADD	W2, W0, W1
	MOV	#lo_addr(_current_time+4), W0
	MOV.B	W1, [W0]
;ds1305_lib.h,54 :: 		current_time.month=(uart1_data[7]-48)+(uart1_data[6]-48)*10;
	MOV	#lo_addr(_uart1_data+7), W0
	ZE	[W0], W1
	MOV	#48, W0
	SUB	W1, W0, W2
	MOV	#lo_addr(_uart1_data+6), W0
	ZE	[W0], W1
	MOV	#48, W0
	SUB	W1, W0, W1
	MOV	#10, W0
	MUL.UU	W1, W0, W0
	ADD	W2, W0, W1
	MOV	#lo_addr(_current_time+5), W0
	MOV.B	W1, [W0]
;ds1305_lib.h,55 :: 		current_time.year=(uart1_data[5]-48)+(uart1_data[4]-48)*10;
	MOV	#lo_addr(_uart1_data+5), W0
	ZE	[W0], W1
	MOV	#48, W0
	SUB	W1, W0, W2
	MOV	#lo_addr(_uart1_data+4), W0
	ZE	[W0], W1
	MOV	#48, W0
	SUB	W1, W0, W1
	MOV	#10, W0
	MUL.UU	W1, W0, W0
	ADD	W2, W0, W1
	MOV	#lo_addr(_current_time+6), W0
	MOV.B	W1, [W0]
;ds1305_lib.h,56 :: 		}
	GOTO	L_rtc_write5
L_rtc_write4:
;ds1305_lib.h,59 :: 		current_time.second=(uart2_data[15]-48)+(uart2_data[14]-48)*10;
	MOV	#lo_addr(_uart2_data+15), W0
	ZE	[W0], W1
	MOV	#48, W0
	SUB	W1, W0, W2
	MOV	#lo_addr(_uart2_data+14), W0
	ZE	[W0], W1
	MOV	#48, W0
	SUB	W1, W0, W1
	MOV	#10, W0
	MUL.UU	W1, W0, W0
	ADD	W2, W0, W1
	MOV	#lo_addr(_current_time+1), W0
	MOV.B	W1, [W0]
;ds1305_lib.h,60 :: 		current_time.minute=(uart2_data[13]-48)+(uart2_data[12]-48)*10;
	MOV	#lo_addr(_uart2_data+13), W0
	ZE	[W0], W1
	MOV	#48, W0
	SUB	W1, W0, W2
	MOV	#lo_addr(_uart2_data+12), W0
	ZE	[W0], W1
	MOV	#48, W0
	SUB	W1, W0, W1
	MOV	#10, W0
	MUL.UU	W1, W0, W0
	ADD	W2, W0, W1
	MOV	#lo_addr(_current_time+2), W0
	MOV.B	W1, [W0]
;ds1305_lib.h,61 :: 		current_time.hour=(uart2_data[11]-48)+(uart2_data[10]-48)*10;
	MOV	#lo_addr(_uart2_data+11), W0
	ZE	[W0], W1
	MOV	#48, W0
	SUB	W1, W0, W2
	MOV	#lo_addr(_uart2_data+10), W0
	ZE	[W0], W1
	MOV	#48, W0
	SUB	W1, W0, W1
	MOV	#10, W0
	MUL.UU	W1, W0, W0
	ADD	W2, W0, W1
	MOV	#lo_addr(_current_time+3), W0
	MOV.B	W1, [W0]
;ds1305_lib.h,62 :: 		current_time.day=(uart2_data[9]-48)+(uart2_data[8]-48)*10;
	MOV	#lo_addr(_uart2_data+9), W0
	ZE	[W0], W1
	MOV	#48, W0
	SUB	W1, W0, W2
	MOV	#lo_addr(_uart2_data+8), W0
	ZE	[W0], W1
	MOV	#48, W0
	SUB	W1, W0, W1
	MOV	#10, W0
	MUL.UU	W1, W0, W0
	ADD	W2, W0, W1
	MOV	#lo_addr(_current_time+4), W0
	MOV.B	W1, [W0]
;ds1305_lib.h,63 :: 		current_time.month=(uart2_data[7]-48)+(uart2_data[6]-48)*10;
	MOV	#lo_addr(_uart2_data+7), W0
	ZE	[W0], W1
	MOV	#48, W0
	SUB	W1, W0, W2
	MOV	#lo_addr(_uart2_data+6), W0
	ZE	[W0], W1
	MOV	#48, W0
	SUB	W1, W0, W1
	MOV	#10, W0
	MUL.UU	W1, W0, W0
	ADD	W2, W0, W1
	MOV	#lo_addr(_current_time+5), W0
	MOV.B	W1, [W0]
;ds1305_lib.h,64 :: 		current_time.year=(uart2_data[5]-48)+(uart2_data[4]-48)*10;
	MOV	#lo_addr(_uart2_data+5), W0
	ZE	[W0], W1
	MOV	#48, W0
	SUB	W1, W0, W2
	MOV	#lo_addr(_uart2_data+4), W0
	ZE	[W0], W1
	MOV	#48, W0
	SUB	W1, W0, W1
	MOV	#10, W0
	MUL.UU	W1, W0, W0
	ADD	W2, W0, W1
	MOV	#lo_addr(_current_time+6), W0
	MOV.B	W1, [W0]
;ds1305_lib.h,65 :: 		}
L_rtc_write5:
;ds1305_lib.h,88 :: 		rtc=0;
	BCLR	LATF0_bit, BitPos(LATF0_bit+0)
;ds1305_lib.h,90 :: 		}
L_end_rtc_write:
	RETURN
; end of _rtc_write

_send_atc:

;gprs.h,1 :: 		void send_atc(const char *s)
;gprs.h,3 :: 		while(*s)
L_send_atc6:
	MOV	#___Lib_System_DefaultPage, W0
	MOV	WREG, 52
	MOV.B	[W10], W0
	CP0.B	W0
	BRA NZ	L__send_atc1051
	GOTO	L_send_atc7
L__send_atc1051:
;gprs.h,5 :: 		if(*s!=10 && *s!=13 && *s!=' ')
	MOV	#___Lib_System_DefaultPage, W0
	MOV	WREG, 52
	MOV.B	[W10], W0
	CP.B	W0, #10
	BRA NZ	L__send_atc1052
	GOTO	L__send_atc838
L__send_atc1052:
	MOV	#___Lib_System_DefaultPage, W0
	MOV	WREG, 52
	MOV.B	[W10], W0
	CP.B	W0, #13
	BRA NZ	L__send_atc1053
	GOTO	L__send_atc837
L__send_atc1053:
	MOV	#___Lib_System_DefaultPage, W0
	MOV	WREG, 52
	MOV.B	[W10], W1
	MOV.B	#32, W0
	CP.B	W1, W0
	BRA NZ	L__send_atc1054
	GOTO	L__send_atc836
L__send_atc1054:
L__send_atc835:
;gprs.h,7 :: 		if(debug_gsm) UART1_Write(*s);
	MOV	#lo_addr(_debug_gsm), W0
	CP0.B	[W0]
	BRA NZ	L__send_atc1055
	GOTO	L_send_atc11
L__send_atc1055:
	MOV	#___Lib_System_DefaultPage, W0
	MOV	WREG, 52
	PUSH	W10
	ZE	[W10], W10
	CALL	_UART1_Write
	POP	W10
L_send_atc11:
;gprs.h,8 :: 		UART2_Write(*s);
	MOV	#___Lib_System_DefaultPage, W0
	MOV	WREG, 52
	PUSH	W10
	ZE	[W10], W10
	CALL	_UART2_Write
	POP	W10
;gprs.h,9 :: 		delay_us(15);
	MOV	#73, W7
L_send_atc12:
	DEC	W7
	BRA NZ	L_send_atc12
	NOP
	NOP
;gprs.h,5 :: 		if(*s!=10 && *s!=13 && *s!=' ')
L__send_atc838:
L__send_atc837:
L__send_atc836:
;gprs.h,11 :: 		s++;
	ADD	W10, #1, W0
	MOV	W0, W10
;gprs.h,14 :: 		}
	GOTO	L_send_atc6
L_send_atc7:
;gprs.h,15 :: 		}
L_end_send_atc:
	RETURN
; end of _send_atc

_send_out:

;gprs.h,16 :: 		void send_out(const char *s)
;gprs.h,18 :: 		while(*s)
L_send_out14:
	MOV	#___Lib_System_DefaultPage, W0
	MOV	WREG, 52
	MOV.B	[W10], W0
	CP0.B	W0
	BRA NZ	L__send_out1057
	GOTO	L_send_out15
L__send_out1057:
;gprs.h,20 :: 		if(*s!=10 && *s!=13)
	MOV	#___Lib_System_DefaultPage, W0
	MOV	WREG, 52
	MOV.B	[W10], W0
	CP.B	W0, #10
	BRA NZ	L__send_out1058
	GOTO	L__send_out841
L__send_out1058:
	MOV	#___Lib_System_DefaultPage, W0
	MOV	WREG, 52
	MOV.B	[W10], W0
	CP.B	W0, #13
	BRA NZ	L__send_out1059
	GOTO	L__send_out840
L__send_out1059:
L__send_out839:
;gprs.h,23 :: 		UART1_Write(*s);
	MOV	#___Lib_System_DefaultPage, W0
	MOV	WREG, 52
	PUSH	W10
	ZE	[W10], W10
	CALL	_UART1_Write
	POP	W10
;gprs.h,26 :: 		delay_us(15);
	MOV	#73, W7
L_send_out19:
	DEC	W7
	BRA NZ	L_send_out19
	NOP
	NOP
;gprs.h,20 :: 		if(*s!=10 && *s!=13)
L__send_out841:
L__send_out840:
;gprs.h,28 :: 		s++;
	ADD	W10, #1, W0
	MOV	W0, W10
;gprs.h,31 :: 		}
	GOTO	L_send_out14
L_send_out15:
;gprs.h,32 :: 		}
L_end_send_out:
	RETURN
; end of _send_out

_set_gprs_timer:

;gprs.h,33 :: 		void set_gprs_timer(unsigned short timer)
;gprs.h,35 :: 		gprs_timer=0;
	MOV	#lo_addr(_gprs_timer), W1
	CLR	W0
	MOV.B	W0, [W1]
;gprs.h,36 :: 		gprs_end_timer=timer+1;
	MOV	#lo_addr(_gprs_end_timer), W0
	ADD.B	W10, #1, [W0]
;gprs.h,37 :: 		gprs_timer_en=1;
	MOV	#lo_addr(_gprs_timer_en), W1
	MOV.B	#1, W0
	MOV.B	W0, [W1]
;gprs.h,38 :: 		}
L_end_set_gprs_timer:
	RETURN
; end of _set_gprs_timer

_sim900_restart:

;gprs.h,39 :: 		void sim900_restart()
;gprs.h,41 :: 		sim_reset=1;
	MOV	#lo_addr(_sim_reset), W1
	MOV.B	#1, W0
	MOV.B	W0, [W1]
;gprs.h,42 :: 		}
L_end_sim900_restart:
	RETURN
; end of _sim900_restart

_spifat_init:

;mmc.h,1 :: 		void spifat_init()
;mmc.h,3 :: 		SPI1_Init_Advanced(_SPI_MASTER, _SPI_8_BIT, _SPI_PRESCALE_SEC_1, _SPI_PRESCALE_PRI_64,_SPI_SS_DISABLE, _SPI_DATA_SAMPLE_MIDDLE, _SPI_CLK_IDLE_LOW, _SPI_IDLE_2_ACTIVE);
	PUSH	W10
	PUSH	W11
	PUSH	W12
	PUSH	W13
	CLR	W13
	MOV	#28, W12
	CLR	W11
	MOV	#32, W10
	MOV	#256, W0
	PUSH	W0
	CLR	W0
	PUSH	W0
	CLR	W0
	PUSH	W0
	CLR	W0
	PUSH	W0
	CALL	_SPI1_Init_Advanced
	SUB	#8, W15
;mmc.h,4 :: 		if(0==Mmc_Init())
	CALL	_Mmc_Init
	CP	W0, #0
	BRA Z	L__spifat_init1063
	GOTO	L_spifat_init21
L__spifat_init1063:
;mmc.h,6 :: 		memory_error=0;
	MOV	#lo_addr(_memory_error), W1
	CLR	W0
	MOV.B	W0, [W1]
;mmc.h,7 :: 		}
	GOTO	L_spifat_init22
L_spifat_init21:
;mmc.h,10 :: 		delay_ms(1);
	MOV	#4914, W7
L_spifat_init23:
	DEC	W7
	BRA NZ	L_spifat_init23
	NOP
	NOP
;mmc.h,11 :: 		if(0==Mmc_Init())
	CALL	_Mmc_Init
	CP	W0, #0
	BRA Z	L__spifat_init1064
	GOTO	L_spifat_init25
L__spifat_init1064:
;mmc.h,13 :: 		memory_error=0;
	MOV	#lo_addr(_memory_error), W1
	CLR	W0
	MOV.B	W0, [W1]
;mmc.h,14 :: 		}
	GOTO	L_spifat_init26
L_spifat_init25:
;mmc.h,17 :: 		memory_error=1;
	MOV	#lo_addr(_memory_error), W1
	MOV.B	#1, W0
	MOV.B	W0, [W1]
;mmc.h,18 :: 		}
L_spifat_init26:
;mmc.h,19 :: 		SPI1_read(0);
	CLR	W10
	CALL	_SPI1_Read
;mmc.h,20 :: 		SPI1_read(0);
	CLR	W10
	CALL	_SPI1_Read
;mmc.h,21 :: 		}
L_spifat_init22:
;mmc.h,23 :: 		SPI1_Init_Advanced(_SPI_MASTER, _SPI_8_BIT, _SPI_PRESCALE_SEC_1, _SPI_PRESCALE_PRI_4,_SPI_SS_DISABLE, _SPI_DATA_SAMPLE_MIDDLE, _SPI_CLK_IDLE_HIGH, _SPI_ACTIVE_2_IDLE); //SPI1_Init_Advanced(_SPI_MASTER, _SPI_8_BIT, _SPI_PRESCALE_SEC_4, _SPI_PRESCALE_PRI_64,_SPI_SS_DISABLE, _SPI_DATA_SAMPLE_MIDDLE, _SPI_CLK_IDLE_HIGH, _SPI_ACTIVE_2_IDLE);
	MOV	#2, W13
	MOV	#28, W12
	CLR	W11
	MOV	#32, W10
	CLR	W0
	PUSH	W0
	MOV	#64, W0
	PUSH	W0
	CLR	W0
	PUSH	W0
	CLR	W0
	PUSH	W0
	CALL	_SPI1_Init_Advanced
	SUB	#8, W15
;mmc.h,24 :: 		SPI1_Write(0xFF);
	MOV	#255, W10
	CALL	_SPI1_Write
;mmc.h,25 :: 		}
L_end_spifat_init:
	POP	W13
	POP	W12
	POP	W11
	POP	W10
	RETURN
; end of _spifat_init

_reset_interval_data:

;interval.h,1 :: 		void reset_interval_data()
;interval.h,3 :: 		for(jj=0;jj<262;jj++) interval_data[jj]='0';
	CLR	W0
	MOV	W0, _jj
L_reset_interval_data27:
	MOV	_jj, W1
	MOV	#262, W0
	CP	W1, W0
	BRA LT	L__reset_interval_data1066
	GOTO	L_reset_interval_data28
L__reset_interval_data1066:
	MOV	#lo_addr(_interval_data), W1
	MOV	#lo_addr(_jj), W0
	ADD	W1, [W0], W1
	MOV.B	#48, W0
	MOV.B	W0, [W1]
	MOV	#1, W1
	MOV	#lo_addr(_jj), W0
	ADD	W1, [W0], [W0]
	GOTO	L_reset_interval_data27
L_reset_interval_data28:
;interval.h,4 :: 		for(jj=0;jj<8;jj++) interval_data[jj]=system_id[jj];
	CLR	W0
	MOV	W0, _jj
L_reset_interval_data30:
	MOV	_jj, W0
	CP	W0, #8
	BRA LT	L__reset_interval_data1067
	GOTO	L_reset_interval_data31
L__reset_interval_data1067:
	MOV	#lo_addr(_interval_data), W1
	MOV	#lo_addr(_jj), W0
	ADD	W1, [W0], W2
	MOV	#lo_addr(_system_id), W1
	MOV	#lo_addr(_jj), W0
	ADD	W1, [W0], W1
	MOV	#___Lib_System_DefaultPage, W0
	MOV	WREG, 52
	MOV.B	[W1], W0
	MOV.B	W0, [W2]
	MOV	#1, W1
	MOV	#lo_addr(_jj), W0
	ADD	W1, [W0], [W0]
	GOTO	L_reset_interval_data30
L_reset_interval_data31:
;interval.h,5 :: 		interval_data[262]=13;
	MOV	#lo_addr(_interval_data+262), W1
	MOV.B	#13, W0
	MOV.B	W0, [W1]
;interval.h,6 :: 		interval_data[263]=10;
	MOV	#lo_addr(_interval_data+263), W1
	MOV.B	#10, W0
	MOV.B	W0, [W1]
;interval.h,7 :: 		interval_data[264]=0;
	MOV	#lo_addr(_interval_data+264), W1
	CLR	W0
	MOV.B	W0, [W1]
;interval.h,8 :: 		}
L_end_reset_interval_data:
	RETURN
; end of _reset_interval_data

_reset_interval:

;interval.h,9 :: 		void reset_interval()
;interval.h,11 :: 		current_interval.l1acount=0;
	CLR	W0
	MOV	W0, _current_interval
;interval.h,12 :: 		current_interval.l1avavg=0;
	MOV	#lo_addr(_current_interval+2), W1
	CLR	W0
	MOV.B	W0, [W1]
;interval.h,13 :: 		current_interval.l1aspeed=0;
	CLR	W0
	MOV	W0, _current_interval+4
;interval.h,14 :: 		current_interval.l1agrab=0;
	CLR	W0
	MOV	W0, _current_interval+6
;interval.h,15 :: 		current_interval.l1aheadway=0;
	CLR	W0
	MOV	W0, _current_interval+8
;interval.h,17 :: 		current_interval.l1bcount=0;
	CLR	W0
	MOV	W0, _current_interval+10
;interval.h,18 :: 		current_interval.l1bvavg=0;
	MOV	#lo_addr(_current_interval+12), W1
	CLR	W0
	MOV.B	W0, [W1]
;interval.h,19 :: 		current_interval.l1bspeed=0;
	CLR	W0
	MOV	W0, _current_interval+14
;interval.h,20 :: 		current_interval.l1bgrab=0;
	CLR	W0
	MOV	W0, _current_interval+16
;interval.h,21 :: 		current_interval.l1bheadway=0;
	CLR	W0
	MOV	W0, _current_interval+18
;interval.h,23 :: 		current_interval.l1ccount=0;
	CLR	W0
	MOV	W0, _current_interval+20
;interval.h,24 :: 		current_interval.l1cvavg=0;
	MOV	#lo_addr(_current_interval+22), W1
	CLR	W0
	MOV.B	W0, [W1]
;interval.h,25 :: 		current_interval.l1cspeed=0;
	CLR	W0
	MOV	W0, _current_interval+24
;interval.h,26 :: 		current_interval.l1cgrab=0;
	CLR	W0
	MOV	W0, _current_interval+26
;interval.h,27 :: 		current_interval.l1cheadway=0;
	CLR	W0
	MOV	W0, _current_interval+28
;interval.h,29 :: 		current_interval.l1dcount=0;
	CLR	W0
	MOV	W0, _current_interval+30
;interval.h,30 :: 		current_interval.l1dvavg=0;
	MOV	#lo_addr(_current_interval+32), W1
	CLR	W0
	MOV.B	W0, [W1]
;interval.h,31 :: 		current_interval.l1dspeed=0;
	CLR	W0
	MOV	W0, _current_interval+34
;interval.h,32 :: 		current_interval.l1dgrab=0;
	CLR	W0
	MOV	W0, _current_interval+36
;interval.h,33 :: 		current_interval.l1dheadway=0;
	CLR	W0
	MOV	W0, _current_interval+38
;interval.h,35 :: 		current_interval.l1ecount=0;
	CLR	W0
	MOV	W0, _current_interval+40
;interval.h,36 :: 		current_interval.l1evavg=0;
	MOV	#lo_addr(_current_interval+42), W1
	CLR	W0
	MOV.B	W0, [W1]
;interval.h,37 :: 		current_interval.l1espeed=0;
	CLR	W0
	MOV	W0, _current_interval+44
;interval.h,38 :: 		current_interval.l1egrab=0;
	CLR	W0
	MOV	W0, _current_interval+46
;interval.h,39 :: 		current_interval.l1eheadway=0;
	CLR	W0
	MOV	W0, _current_interval+48
;interval.h,41 :: 		current_interval.l1xcount=0;
	CLR	W0
	MOV	W0, _current_interval+50
;interval.h,42 :: 		current_interval.l1xvavg=0;
	MOV	#lo_addr(_current_interval+52), W1
	CLR	W0
	MOV.B	W0, [W1]
;interval.h,43 :: 		current_interval.l1xspeed=0;
	CLR	W0
	MOV	W0, _current_interval+54
;interval.h,44 :: 		current_interval.l1xgrab=0;
	CLR	W0
	MOV	W0, _current_interval+56
;interval.h,45 :: 		current_interval.l1xheadway=0;
	CLR	W0
	MOV	W0, _current_interval+58
;interval.h,47 :: 		current_interval.l2acount=0;
	CLR	W0
	MOV	W0, _current_interval+62
;interval.h,48 :: 		current_interval.l2avavg=0;
	MOV	#lo_addr(_current_interval+64), W1
	CLR	W0
	MOV.B	W0, [W1]
;interval.h,49 :: 		current_interval.l2aspeed=0;
	CLR	W0
	MOV	W0, _current_interval+66
;interval.h,50 :: 		current_interval.l2agrab=0;
	CLR	W0
	MOV	W0, _current_interval+68
;interval.h,51 :: 		current_interval.l2aheadway=0;
	CLR	W0
	MOV	W0, _current_interval+70
;interval.h,53 :: 		current_interval.l2bcount=0;
	CLR	W0
	MOV	W0, _current_interval+72
;interval.h,54 :: 		current_interval.l2bvavg=0;
	MOV	#lo_addr(_current_interval+74), W1
	CLR	W0
	MOV.B	W0, [W1]
;interval.h,55 :: 		current_interval.l2bspeed=0;
	CLR	W0
	MOV	W0, _current_interval+76
;interval.h,56 :: 		current_interval.l2bgrab=0;
	CLR	W0
	MOV	W0, _current_interval+78
;interval.h,57 :: 		current_interval.l2bheadway=0;
	CLR	W0
	MOV	W0, _current_interval+80
;interval.h,59 :: 		current_interval.l2ccount=0;
	CLR	W0
	MOV	W0, _current_interval+82
;interval.h,60 :: 		current_interval.l2cvavg=0;
	MOV	#lo_addr(_current_interval+84), W1
	CLR	W0
	MOV.B	W0, [W1]
;interval.h,61 :: 		current_interval.l2cvavgnew=0;
	MOV	#lo_addr(_current_interval+85), W1
	CLR	W0
	MOV.B	W0, [W1]
;interval.h,62 :: 		current_interval.l2cspeed=0;
	CLR	W0
	MOV	W0, _current_interval+86
;interval.h,63 :: 		current_interval.l2cgrab=0;
	CLR	W0
	MOV	W0, _current_interval+88
;interval.h,64 :: 		current_interval.l2cheadway=0;
	CLR	W0
	MOV	W0, _current_interval+90
;interval.h,66 :: 		current_interval.l2dcount=0;
	CLR	W0
	MOV	W0, _current_interval+92
;interval.h,67 :: 		current_interval.l2dvavg=0;
	MOV	#lo_addr(_current_interval+94), W1
	CLR	W0
	MOV.B	W0, [W1]
;interval.h,68 :: 		current_interval.l2dspeed=0;
	CLR	W0
	MOV	W0, _current_interval+96
;interval.h,69 :: 		current_interval.l2dgrab=0;
	CLR	W0
	MOV	W0, _current_interval+98
;interval.h,70 :: 		current_interval.l2dheadway=0;
	CLR	W0
	MOV	W0, _current_interval+100
;interval.h,72 :: 		current_interval.l2ecount=0;
	CLR	W0
	MOV	W0, _current_interval+102
;interval.h,73 :: 		current_interval.l2evavg=0;
	MOV	#lo_addr(_current_interval+104), W1
	CLR	W0
	MOV.B	W0, [W1]
;interval.h,74 :: 		current_interval.l2espeed=0;
	CLR	W0
	MOV	W0, _current_interval+106
;interval.h,75 :: 		current_interval.l2egrab=0;
	CLR	W0
	MOV	W0, _current_interval+108
;interval.h,76 :: 		current_interval.l2eheadway=0;
	CLR	W0
	MOV	W0, _current_interval+110
;interval.h,78 :: 		current_interval.l2xcount=0;
	CLR	W0
	MOV	W0, _current_interval+112
;interval.h,79 :: 		current_interval.l2xvavg=0;
	MOV	#lo_addr(_current_interval+114), W1
	CLR	W0
	MOV.B	W0, [W1]
;interval.h,80 :: 		current_interval.l2xspeed=0;
	CLR	W0
	MOV	W0, _current_interval+116
;interval.h,81 :: 		current_interval.l2xgrab=0;
	CLR	W0
	MOV	W0, _current_interval+118
;interval.h,82 :: 		current_interval.l2xheadway=0;
	CLR	W0
	MOV	W0, _current_interval+120
;interval.h,85 :: 		totalv1a=0;
	CLR	W0
	CLR	W1
	MOV	W0, _totalv1a
	MOV	W1, _totalv1a+2
;interval.h,86 :: 		totalv1b=0;
	CLR	W0
	CLR	W1
	MOV	W0, _totalv1b
	MOV	W1, _totalv1b+2
;interval.h,87 :: 		totalv1c=0;
	CLR	W0
	CLR	W1
	MOV	W0, _totalv1c
	MOV	W1, _totalv1c+2
;interval.h,88 :: 		totalv1d=0;
	CLR	W0
	CLR	W1
	MOV	W0, _totalv1d
	MOV	W1, _totalv1d+2
;interval.h,89 :: 		totalv1e=0;
	CLR	W0
	CLR	W1
	MOV	W0, _totalv1e
	MOV	W1, _totalv1e+2
;interval.h,90 :: 		totalv1x=0;
	CLR	W0
	CLR	W1
	MOV	W0, _totalv1x
	MOV	W1, _totalv1x+2
;interval.h,91 :: 		totalv2a=0;
	CLR	W0
	CLR	W1
	MOV	W0, _totalv2a
	MOV	W1, _totalv2a+2
;interval.h,92 :: 		totalv2b=0;
	CLR	W0
	CLR	W1
	MOV	W0, _totalv2b
	MOV	W1, _totalv2b+2
;interval.h,93 :: 		totalv2c=0;
	CLR	W0
	CLR	W1
	MOV	W0, _totalv2c
	MOV	W1, _totalv2c+2
;interval.h,95 :: 		totalv2d=0;
	CLR	W0
	CLR	W1
	MOV	W0, _totalv2d
	MOV	W1, _totalv2d+2
;interval.h,96 :: 		totalv2e=0;
	CLR	W0
	CLR	W1
	MOV	W0, _totalv2e
	MOV	W1, _totalv2e+2
;interval.h,97 :: 		totalv2x=0;
	CLR	W0
	CLR	W1
	MOV	W0, _totalv2x
	MOV	W1, _totalv2x+2
;interval.h,99 :: 		l1occ=0;
	CLR	W0
	CLR	W1
	MOV	W0, _l1occ
	MOV	W1, _l1occ+2
;interval.h,100 :: 		l2occ=0;
	CLR	W0
	CLR	W1
	MOV	W0, _l2occ
	MOV	W1, _l2occ+2
;interval.h,102 :: 		}
L_end_reset_interval:
	RETURN
; end of _reset_interval

_cal_interval:

;interval.h,103 :: 		void cal_interval()
;interval.h,105 :: 		reset_interval_data();
	PUSH	W10
	PUSH	W11
	CALL	_reset_interval_data
;interval.h,107 :: 		if(current_interval.l1acount>0) current_interval.l1avavg=(unsigned short)(totalv1a/current_interval.l1acount);
	MOV	_current_interval, W0
	CP	W0, #0
	BRA GT	L__cal_interval1070
	GOTO	L_cal_interval33
L__cal_interval1070:
	MOV	_current_interval, W2
	ASR	W2, #15, W3
	MOV	_totalv1a, W0
	MOV	_totalv1a+2, W1
	CLR	W4
	CALL	__Divide_32x32
	MOV	#lo_addr(_current_interval+2), W2
	MOV.B	W0, [W2]
	GOTO	L_cal_interval34
L_cal_interval33:
;interval.h,108 :: 		else  current_interval.l1avavg=0;
	MOV	#lo_addr(_current_interval+2), W1
	CLR	W0
	MOV.B	W0, [W1]
L_cal_interval34:
;interval.h,110 :: 		if(current_interval.l1bcount>0) current_interval.l1bvavg=(unsigned short)(totalv1b/current_interval.l1bcount);
	MOV	_current_interval+10, W0
	CP	W0, #0
	BRA GT	L__cal_interval1071
	GOTO	L_cal_interval35
L__cal_interval1071:
	MOV	_current_interval+10, W2
	ASR	W2, #15, W3
	MOV	_totalv1b, W0
	MOV	_totalv1b+2, W1
	CLR	W4
	CALL	__Divide_32x32
	MOV	#lo_addr(_current_interval+12), W2
	MOV.B	W0, [W2]
	GOTO	L_cal_interval36
L_cal_interval35:
;interval.h,111 :: 		else  current_interval.l1bvavg=0;
	MOV	#lo_addr(_current_interval+12), W1
	CLR	W0
	MOV.B	W0, [W1]
L_cal_interval36:
;interval.h,113 :: 		if(current_interval.l1ccount>0) current_interval.l1cvavg=(unsigned short)(totalv1c/current_interval.l1ccount);
	MOV	_current_interval+20, W0
	CP	W0, #0
	BRA GT	L__cal_interval1072
	GOTO	L_cal_interval37
L__cal_interval1072:
	MOV	_current_interval+20, W2
	ASR	W2, #15, W3
	MOV	_totalv1c, W0
	MOV	_totalv1c+2, W1
	CLR	W4
	CALL	__Divide_32x32
	MOV	#lo_addr(_current_interval+22), W2
	MOV.B	W0, [W2]
	GOTO	L_cal_interval38
L_cal_interval37:
;interval.h,114 :: 		else  current_interval.l1cvavg=0;
	MOV	#lo_addr(_current_interval+22), W1
	CLR	W0
	MOV.B	W0, [W1]
L_cal_interval38:
;interval.h,116 :: 		if(current_interval.l1dcount>0) current_interval.l1dvavg=(unsigned short)(totalv1d/current_interval.l1dcount);
	MOV	_current_interval+30, W0
	CP	W0, #0
	BRA GT	L__cal_interval1073
	GOTO	L_cal_interval39
L__cal_interval1073:
	MOV	_current_interval+30, W2
	ASR	W2, #15, W3
	MOV	_totalv1d, W0
	MOV	_totalv1d+2, W1
	CLR	W4
	CALL	__Divide_32x32
	MOV	#lo_addr(_current_interval+32), W2
	MOV.B	W0, [W2]
	GOTO	L_cal_interval40
L_cal_interval39:
;interval.h,117 :: 		else  current_interval.l1dvavg=0;
	MOV	#lo_addr(_current_interval+32), W1
	CLR	W0
	MOV.B	W0, [W1]
L_cal_interval40:
;interval.h,119 :: 		if(current_interval.l1ecount>0) current_interval.l1evavg=(unsigned short)(totalv1e/current_interval.l1ecount);
	MOV	_current_interval+40, W0
	CP	W0, #0
	BRA GT	L__cal_interval1074
	GOTO	L_cal_interval41
L__cal_interval1074:
	MOV	_current_interval+40, W2
	ASR	W2, #15, W3
	MOV	_totalv1e, W0
	MOV	_totalv1e+2, W1
	CLR	W4
	CALL	__Divide_32x32
	MOV	#lo_addr(_current_interval+42), W2
	MOV.B	W0, [W2]
	GOTO	L_cal_interval42
L_cal_interval41:
;interval.h,120 :: 		else  current_interval.l1evavg=0;
	MOV	#lo_addr(_current_interval+42), W1
	CLR	W0
	MOV.B	W0, [W1]
L_cal_interval42:
;interval.h,122 :: 		if(current_interval.l1xcount>0) current_interval.l1xvavg=(unsigned short)(totalv1x/current_interval.l1xcount);
	MOV	_current_interval+50, W0
	CP	W0, #0
	BRA GT	L__cal_interval1075
	GOTO	L_cal_interval43
L__cal_interval1075:
	MOV	_current_interval+50, W2
	ASR	W2, #15, W3
	MOV	_totalv1x, W0
	MOV	_totalv1x+2, W1
	CLR	W4
	CALL	__Divide_32x32
	MOV	#lo_addr(_current_interval+52), W2
	MOV.B	W0, [W2]
	GOTO	L_cal_interval44
L_cal_interval43:
;interval.h,123 :: 		else  current_interval.l1xvavg=0;
	MOV	#lo_addr(_current_interval+52), W1
	CLR	W0
	MOV.B	W0, [W1]
L_cal_interval44:
;interval.h,125 :: 		if(current_interval.l2acount>0) current_interval.l2avavg=(unsigned short)(totalv2a/current_interval.l2acount);
	MOV	_current_interval+62, W0
	CP	W0, #0
	BRA GT	L__cal_interval1076
	GOTO	L_cal_interval45
L__cal_interval1076:
	MOV	_current_interval+62, W2
	ASR	W2, #15, W3
	MOV	_totalv2a, W0
	MOV	_totalv2a+2, W1
	CLR	W4
	CALL	__Divide_32x32
	MOV	#lo_addr(_current_interval+64), W2
	MOV.B	W0, [W2]
	GOTO	L_cal_interval46
L_cal_interval45:
;interval.h,126 :: 		else  current_interval.l2avavg=0;
	MOV	#lo_addr(_current_interval+64), W1
	CLR	W0
	MOV.B	W0, [W1]
L_cal_interval46:
;interval.h,128 :: 		if(current_interval.l2bcount>0) current_interval.l2bvavg=(unsigned short)(totalv2b/current_interval.l2bcount);
	MOV	_current_interval+72, W0
	CP	W0, #0
	BRA GT	L__cal_interval1077
	GOTO	L_cal_interval47
L__cal_interval1077:
	MOV	_current_interval+72, W2
	ASR	W2, #15, W3
	MOV	_totalv2b, W0
	MOV	_totalv2b+2, W1
	CLR	W4
	CALL	__Divide_32x32
	MOV	#lo_addr(_current_interval+74), W2
	MOV.B	W0, [W2]
	GOTO	L_cal_interval48
L_cal_interval47:
;interval.h,129 :: 		else  current_interval.l2bvavg=0;
	MOV	#lo_addr(_current_interval+74), W1
	CLR	W0
	MOV.B	W0, [W1]
L_cal_interval48:
;interval.h,131 :: 		if(current_interval.l2ccount>0) current_interval.l2cvavg=(unsigned short)(totalv2c/(unsigned long)(current_interval.l2ccount));
	MOV	_current_interval+82, W0
	CP	W0, #0
	BRA GT	L__cal_interval1078
	GOTO	L_cal_interval49
L__cal_interval1078:
	MOV	_current_interval+82, W2
	ASR	W2, #15, W3
	MOV	_totalv2c, W0
	MOV	_totalv2c+2, W1
	CLR	W4
	CALL	__Divide_32x32
	MOV	#lo_addr(_current_interval+84), W2
	MOV.B	W0, [W2]
	GOTO	L_cal_interval50
L_cal_interval49:
;interval.h,132 :: 		else  current_interval.l2cvavg=0;
	MOV	#lo_addr(_current_interval+84), W1
	CLR	W0
	MOV.B	W0, [W1]
L_cal_interval50:
;interval.h,134 :: 		if(current_interval.l2dcount>0) current_interval.l2dvavg=(unsigned short)(totalv2d/current_interval.l2dcount);
	MOV	_current_interval+92, W0
	CP	W0, #0
	BRA GT	L__cal_interval1079
	GOTO	L_cal_interval51
L__cal_interval1079:
	MOV	_current_interval+92, W2
	ASR	W2, #15, W3
	MOV	_totalv2d, W0
	MOV	_totalv2d+2, W1
	CLR	W4
	CALL	__Divide_32x32
	MOV	#lo_addr(_current_interval+94), W2
	MOV.B	W0, [W2]
	GOTO	L_cal_interval52
L_cal_interval51:
;interval.h,135 :: 		else  current_interval.l2dvavg=0;
	MOV	#lo_addr(_current_interval+94), W1
	CLR	W0
	MOV.B	W0, [W1]
L_cal_interval52:
;interval.h,137 :: 		if(current_interval.l2ecount>0) current_interval.l2evavg=(unsigned short)(totalv2e/current_interval.l2ecount);
	MOV	_current_interval+102, W0
	CP	W0, #0
	BRA GT	L__cal_interval1080
	GOTO	L_cal_interval53
L__cal_interval1080:
	MOV	_current_interval+102, W2
	ASR	W2, #15, W3
	MOV	_totalv2e, W0
	MOV	_totalv2e+2, W1
	CLR	W4
	CALL	__Divide_32x32
	MOV	#lo_addr(_current_interval+104), W2
	MOV.B	W0, [W2]
	GOTO	L_cal_interval54
L_cal_interval53:
;interval.h,138 :: 		else  current_interval.l2evavg=0;
	MOV	#lo_addr(_current_interval+104), W1
	CLR	W0
	MOV.B	W0, [W1]
L_cal_interval54:
;interval.h,140 :: 		if(current_interval.l2xcount>0) current_interval.l2xvavg=(unsigned short)(totalv2x/current_interval.l2xcount);
	MOV	_current_interval+112, W0
	CP	W0, #0
	BRA GT	L__cal_interval1081
	GOTO	L_cal_interval55
L__cal_interval1081:
	MOV	_current_interval+112, W2
	ASR	W2, #15, W3
	MOV	_totalv2x, W0
	MOV	_totalv2x+2, W1
	CLR	W4
	CALL	__Divide_32x32
	MOV	#lo_addr(_current_interval+114), W2
	MOV.B	W0, [W2]
	GOTO	L_cal_interval56
L_cal_interval55:
;interval.h,141 :: 		else  current_interval.l2xvavg=0;
	MOV	#lo_addr(_current_interval+114), W1
	CLR	W0
	MOV.B	W0, [W1]
L_cal_interval56:
;interval.h,143 :: 		bytetostr(current_time.year,tmp3);
	MOV	#lo_addr(_tmp3), W11
	MOV	#lo_addr(_current_time+6), W0
	MOV.B	[W0], W10
	CALL	_ByteToStr
;interval.h,144 :: 		interval_data[8]=tmp3[1];
	MOV	#lo_addr(_interval_data+8), W1
	MOV	#lo_addr(_tmp3+1), W0
	MOV.B	[W0], [W1]
;interval.h,145 :: 		interval_data[9]=tmp3[2];
	MOV	#lo_addr(_interval_data+9), W1
	MOV	#lo_addr(_tmp3+2), W0
	MOV.B	[W0], [W1]
;interval.h,146 :: 		bytetostr(current_time.month,tmp3);
	MOV	#lo_addr(_tmp3), W11
	MOV	#lo_addr(_current_time+5), W0
	MOV.B	[W0], W10
	CALL	_ByteToStr
;interval.h,147 :: 		interval_data[10]=tmp3[1];
	MOV	#lo_addr(_interval_data+10), W1
	MOV	#lo_addr(_tmp3+1), W0
	MOV.B	[W0], [W1]
;interval.h,148 :: 		interval_data[11]=tmp3[2];
	MOV	#lo_addr(_interval_data+11), W1
	MOV	#lo_addr(_tmp3+2), W0
	MOV.B	[W0], [W1]
;interval.h,149 :: 		bytetostr(current_time.day,tmp3);
	MOV	#lo_addr(_tmp3), W11
	MOV	#lo_addr(_current_time+4), W0
	MOV.B	[W0], W10
	CALL	_ByteToStr
;interval.h,150 :: 		interval_data[12]=tmp3[1];
	MOV	#lo_addr(_interval_data+12), W1
	MOV	#lo_addr(_tmp3+1), W0
	MOV.B	[W0], [W1]
;interval.h,151 :: 		interval_data[13]=tmp3[2];
	MOV	#lo_addr(_interval_data+13), W1
	MOV	#lo_addr(_tmp3+2), W0
	MOV.B	[W0], [W1]
;interval.h,152 :: 		bytetostr(current_time.hour,tmp3);
	MOV	#lo_addr(_tmp3), W11
	MOV	#lo_addr(_current_time+3), W0
	MOV.B	[W0], W10
	CALL	_ByteToStr
;interval.h,153 :: 		interval_data[14]=tmp3[1];
	MOV	#lo_addr(_interval_data+14), W1
	MOV	#lo_addr(_tmp3+1), W0
	MOV.B	[W0], [W1]
;interval.h,154 :: 		interval_data[15]=tmp3[2];
	MOV	#lo_addr(_interval_data+15), W1
	MOV	#lo_addr(_tmp3+2), W0
	MOV.B	[W0], [W1]
;interval.h,155 :: 		bytetostr(current_time.minute,tmp3);
	MOV	#lo_addr(_tmp3), W11
	MOV	#lo_addr(_current_time+2), W0
	MOV.B	[W0], W10
	CALL	_ByteToStr
;interval.h,156 :: 		interval_data[16]=tmp3[1];
	MOV	#lo_addr(_interval_data+16), W1
	MOV	#lo_addr(_tmp3+1), W0
	MOV.B	[W0], [W1]
;interval.h,157 :: 		interval_data[17]=tmp3[2];
	MOV	#lo_addr(_interval_data+17), W1
	MOV	#lo_addr(_tmp3+2), W0
	MOV.B	[W0], [W1]
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
	CALL	__Mul_FP
	MOV	#0, W2
	MOV	#16608, W3
	CALL	__AddSub_FP
	CALL	__Float2Longint
	MOV	#lo_addr(_debug_txt), W11
	MOV	W0, W10
	CALL	_IntToStr
;interval.h,525 :: 		interval_data[252]=debug_txt[3];
	MOV	#lo_addr(_interval_data+252), W1
	MOV	#lo_addr(_debug_txt+3), W0
	MOV.B	[W0], [W1]
;interval.h,526 :: 		interval_data[253]=debug_txt[4];
	MOV	#lo_addr(_interval_data+253), W1
	MOV	#lo_addr(_debug_txt+4), W0
	MOV.B	[W0], [W1]
;interval.h,527 :: 		interval_data[254]=debug_txt[5];
	MOV	#lo_addr(_interval_data+254), W1
	MOV	#lo_addr(_debug_txt+5), W0
	MOV.B	[W0], [W1]
;interval.h,529 :: 		if(solar<50)
	MOV	#50, W1
	MOV	#0, W2
	MOV	#lo_addr(_solar), W0
	CP	W1, [W0++]
	CPB	W2, [W0--]
	BRA GT	L__cal_interval1082
	GOTO	L_cal_interval57
L__cal_interval1082:
;interval.h,530 :: 		inttostr(0,debug_txt);
	MOV	#lo_addr(_debug_txt), W11
	CLR	W10
	CALL	_IntToStr
	GOTO	L_cal_interval58
L_cal_interval57:
;interval.h,532 :: 		inttostr((int)(solar*0.388509),debug_txt);
	MOV	_solar, W0
	MOV	_solar+2, W1
	SETM	W2
	CALL	__Long2Float
	MOV	#60071, W2
	MOV	#16070, W3
	CALL	__Mul_FP
	CALL	__Float2Longint
	MOV	#lo_addr(_debug_txt), W11
	MOV	W0, W10
	CALL	_IntToStr
L_cal_interval58:
;interval.h,533 :: 		interval_data[255]=debug_txt[3];
	MOV	#lo_addr(_interval_data+255), W1
	MOV	#lo_addr(_debug_txt+3), W0
	MOV.B	[W0], [W1]
;interval.h,534 :: 		interval_data[256]=debug_txt[4];
	MOV	#lo_addr(_interval_data+256), W1
	MOV	#lo_addr(_debug_txt+4), W0
	MOV.B	[W0], [W1]
;interval.h,535 :: 		interval_data[257]=debug_txt[5];
	MOV	#lo_addr(_interval_data+257), W1
	MOV	#lo_addr(_debug_txt+5), W0
	MOV.B	[W0], [W1]
;interval.h,538 :: 		inttostr(error_byte,debug_txt);
	MOV	#lo_addr(_debug_txt), W11
	MOV	_error_byte, W10
	CALL	_IntToStr
;interval.h,539 :: 		interval_data[258]=debug_txt[2];
	MOV	#lo_addr(_interval_data+258), W1
	MOV	#lo_addr(_debug_txt+2), W0
	MOV.B	[W0], [W1]
;interval.h,540 :: 		interval_data[259]=debug_txt[3];
	MOV	#lo_addr(_interval_data+259), W1
	MOV	#lo_addr(_debug_txt+3), W0
	MOV.B	[W0], [W1]
;interval.h,541 :: 		interval_data[260]=debug_txt[4];
	MOV	#lo_addr(_interval_data+260), W1
	MOV	#lo_addr(_debug_txt+4), W0
	MOV.B	[W0], [W1]
;interval.h,542 :: 		interval_data[261]=debug_txt[5];
	MOV	#lo_addr(_interval_data+261), W1
	MOV	#lo_addr(_debug_txt+5), W0
	MOV.B	[W0], [W1]
;interval.h,546 :: 		reset_interval();
	CALL	_reset_interval
;interval.h,548 :: 		for(cal_interval_cnt=0;cal_interval_cnt<262;cal_interval_cnt++) if(interval_data[cal_interval_cnt]==' ') interval_data[cal_interval_cnt]='0';
	CLR	W0
	MOV	W0, _cal_interval_cnt
L_cal_interval59:
	MOV	_cal_interval_cnt, W1
	MOV	#262, W0
	CP	W1, W0
	BRA LTU	L__cal_interval1083
	GOTO	L_cal_interval60
L__cal_interval1083:
	MOV	#lo_addr(_interval_data), W1
	MOV	#lo_addr(_cal_interval_cnt), W0
	ADD	W1, [W0], W0
	MOV.B	[W0], W1
	MOV.B	#32, W0
	CP.B	W1, W0
	BRA Z	L__cal_interval1084
	GOTO	L_cal_interval62
L__cal_interval1084:
	MOV	#lo_addr(_interval_data), W1
	MOV	#lo_addr(_cal_interval_cnt), W0
	ADD	W1, [W0], W1
	MOV.B	#48, W0
	MOV.B	W0, [W1]
L_cal_interval62:
	MOV	#1, W1
	MOV	#lo_addr(_cal_interval_cnt), W0
	ADD	W1, [W0], [W0]
	GOTO	L_cal_interval59
L_cal_interval60:
;interval.h,549 :: 		}
L_end_cal_interval:
	POP	W11
	POP	W10
	RETURN
; end of _cal_interval

_tris_init:

;capture_int_lib.h,1 :: 		void tris_init()
;capture_int_lib.h,3 :: 		TRISB.RB3=0;
	BCLR	TRISB, #3
;capture_int_lib.h,4 :: 		TRISB.RB5=0;
	BCLR	TRISB, #5
;capture_int_lib.h,5 :: 		mmc_error=0;
	BCLR	LATB5_bit, BitPos(LATB5_bit+0)
;capture_int_lib.h,6 :: 		TRISB.RB6=1;
	BSET	TRISB, #6
;capture_int_lib.h,7 :: 		TRISB.RB7=0;
	BCLR	TRISB, #7
;capture_int_lib.h,8 :: 		LATB.RB7=0;
	BCLR	LATB, #7
;capture_int_lib.h,9 :: 		TRISB.RB8=0;
	BCLR	TRISB, #8
;capture_int_lib.h,12 :: 		TRISB.RB0=1;
	BSET	TRISB, #0
;capture_int_lib.h,13 :: 		TRISB.RB1=1;
	BSET	TRISB, #1
;capture_int_lib.h,14 :: 		TRISB.RB4=1;
	BSET	TRISB, #4
;capture_int_lib.h,15 :: 		TRISF.RF0=0;
	BCLR	TRISF, #0
;capture_int_lib.h,16 :: 		TRISF.RF1=0;
	BCLR	TRISF, #1
;capture_int_lib.h,17 :: 		TRISF.RF2=1;
	BSET	TRISF, #2
;capture_int_lib.h,18 :: 		TRISF.RF3=0;
	BCLR	TRISF, #3
;capture_int_lib.h,19 :: 		TRISF.RF4=1;
	BSET	TRISF, #4
;capture_int_lib.h,20 :: 		TRISF.RF5=0;
	BCLR	TRISF, #5
;capture_int_lib.h,21 :: 		TRISF.RF6=0;
	BCLR	TRISF, #6
;capture_int_lib.h,22 :: 		TRISE.RE0=0;
	BCLR	TRISE, #0
;capture_int_lib.h,23 :: 		TRISE.RE1=0;
	BCLR	TRISE, #1
;capture_int_lib.h,24 :: 		TRISE.RE2=0;
	BCLR	TRISE, #2
;capture_int_lib.h,25 :: 		TRISE.RE3=0;
	BCLR	TRISE, #3
;capture_int_lib.h,26 :: 		TRISE.RE4=0;
	BCLR	TRISE, #4
;capture_int_lib.h,27 :: 		TRISE.RE5=0;
	BCLR	TRISE, #5
;capture_int_lib.h,28 :: 		TRISE.RE8=1;
	BSET	TRISE, #8
;capture_int_lib.h,29 :: 		TRISC.RC13=0;
	BCLR	TRISC, #13
;capture_int_lib.h,30 :: 		TRISC.RC14=1;
	BSET	TRISC, #14
;capture_int_lib.h,31 :: 		TRISD=0;
	CLR	TRISD
;capture_int_lib.h,32 :: 		LATD=0;
	CLR	LATD
;capture_int_lib.h,33 :: 		TRISB.RB2=0;
	BCLR	TRISB, #2
;capture_int_lib.h,36 :: 		}
L_end_tris_init:
	RETURN
; end of _tris_init

_tmrcp_init:

;capture_int_lib.h,37 :: 		void tmrcp_init()
;capture_int_lib.h,39 :: 		current_loop=0;
	MOV	#lo_addr(_current_loop), W1
	CLR	W0
	MOV.B	W0, [W1]
;capture_int_lib.h,40 :: 		docal=0;
	MOV	#lo_addr(_docal), W1
	CLR	W0
	MOV.B	W0, [W1]
;capture_int_lib.h,41 :: 		TMR2=0x0000;
	CLR	TMR2
;capture_int_lib.h,42 :: 		T2CON=0x0000;
	CLR	T2CON
;capture_int_lib.h,43 :: 		T4CON=0x0000;
	CLR	T4CON
;capture_int_lib.h,44 :: 		PR4=14744;
	MOV	#14744, W0
	MOV	WREG, PR4
;capture_int_lib.h,45 :: 		T4IF_bit=0;
	BCLR	T4IF_bit, BitPos(T4IF_bit+0)
;capture_int_lib.h,46 :: 		T4IE_bit=1;
	BSET	T4IE_bit, BitPos(T4IE_bit+0)
;capture_int_lib.h,47 :: 		if(AUTCAL) IC7CON=0x00E5;
	MOV	#lo_addr(_AUTCAL), W0
	CP0	[W0]
	BRA NZ	L__tmrcp_init1087
	GOTO	L_tmrcp_init63
L__tmrcp_init1087:
	MOV	#229, W0
	MOV	WREG, IC7CON
	GOTO	L_tmrcp_init64
L_tmrcp_init63:
;capture_int_lib.h,48 :: 		else IC7CON=0x00E4;
	MOV	#228, W0
	MOV	WREG, IC7CON
L_tmrcp_init64:
;capture_int_lib.h,49 :: 		T4CON.TON=1;
	BSET	T4CON, #15
;capture_int_lib.h,50 :: 		T2CON.TON=1;
	BSET	T2CON, #15
;capture_int_lib.h,51 :: 		T4CON.TSIDL=0;
	BCLR	T4CON, #13
;capture_int_lib.h,52 :: 		T2CON.TSIDL=0;
	BCLR	T2CON, #13
;capture_int_lib.h,53 :: 		}
L_end_tmrcp_init:
	RETURN
; end of _tmrcp_init

_uart_init:

;uart_int_lib.h,1 :: 		void uart_init()
;uart_int_lib.h,3 :: 		UART1_init(115200);                          //   Setting UART Data
	PUSH	W10
	PUSH	W11
	MOV	#49664, W10
	MOV	#1, W11
	CALL	_UART1_Init
;uart_int_lib.h,4 :: 		U1MODE.ALTIO=1;
	BSET	U1MODE, #10
;uart_int_lib.h,5 :: 		U1MODE.USIDL=0;
	BCLR	U1MODE, #13
;uart_int_lib.h,6 :: 		U2MODE.USIDL=0;
	BCLR	U2MODE, #13
;uart_int_lib.h,7 :: 		U1RXIF_bit=0;
	BCLR	U1RXIF_bit, BitPos(U1RXIF_bit+0)
;uart_int_lib.h,8 :: 		UART2_init(115200);
	MOV	#49664, W10
	MOV	#1, W11
	CALL	_UART2_Init
;uart_int_lib.h,9 :: 		clear_uart1();
	CALL	_clear_uart1
;uart_int_lib.h,10 :: 		U1RXIE_bit=1;
	BSET	U1RXIE_bit, BitPos(U1RXIE_bit+0)
;uart_int_lib.h,12 :: 		clear_uart2();
	CALL	_clear_uart2
;uart_int_lib.h,13 :: 		U2RXIF_bit=0;
	BCLR	U2RXIF_bit, BitPos(U2RXIF_bit+0)
;uart_int_lib.h,14 :: 		U2RXIE_bit=1;
	BSET	U2RXIE_bit, BitPos(U2RXIE_bit+0)
;uart_int_lib.h,15 :: 		uart2_data_received=0;
	MOV	#lo_addr(_uart2_data_received), W1
	CLR	W0
	MOV.B	W0, [W1]
;uart_int_lib.h,16 :: 		uart2_data_received2=0;
	MOV	#lo_addr(_uart2_data_received2), W1
	CLR	W0
	MOV.B	W0, [W1]
;uart_int_lib.h,18 :: 		U1STAbits.OERR=0;
	BCLR	U1STAbits, #1
;uart_int_lib.h,19 :: 		U2STAbits.OERR=0;
	BCLR	U2STAbits, #1
;uart_int_lib.h,20 :: 		u2func=0;
	CLR	W0
	MOV	W0, _u2func
;uart_int_lib.h,21 :: 		function_code=0;
	CLR	W0
	MOV	W0, _function_code
;uart_int_lib.h,22 :: 		send_out("Started, Step:");
	MOV	#lo_addr(?lstr_1_91_457), W10
	CALL	_send_out
;uart_int_lib.h,23 :: 		wordtostr((RCON-8192),tmp7);
	MOV	RCON, W1
	MOV	#8192, W0
	SUB	W1, W0, W0
	MOV	#lo_addr(_tmp7), W11
	MOV	W0, W10
	CALL	_WordToStr
;uart_int_lib.h,24 :: 		UART1_Write_Text(tmp7);
	MOV	#lo_addr(_tmp7), W10
	CALL	_UART1_Write_Text
;uart_int_lib.h,25 :: 		send_out("  MMC Error:");
	MOV	#lo_addr(?lstr_2_91_457), W10
	CALL	_send_out
;uart_int_lib.h,26 :: 		RCON=0x0000;
	CLR	RCON
;uart_int_lib.h,27 :: 		}
L_end_uart_init:
	POP	W11
	POP	W10
	RETURN
; end of _uart_init

_UART1INT:
	PUSH	52
	PUSH	RCOUNT
	PUSH	W0
	MOV	#2, W0
	REPEAT	#12
	PUSH	[W0++]

;uart_int_lib.h,28 :: 		void UART1INT() iv IVT_ADDR_U1RXINTERRUPT
;uart_int_lib.h,30 :: 		while(U1STAbits.URXDA)
	PUSH	W10
L_UART1INT65:
	BTSS	U1STAbits, #0
	GOTO	L_UART1INT66
;uart_int_lib.h,32 :: 		udata=UART1_Read();
	CALL	_UART1_Read
	MOV	#lo_addr(_udata), W1
	MOV.B	W0, [W1]
;uart_int_lib.h,33 :: 		UART1_Write(udata);
	ZE	W0, W10
	CALL	_UART1_Write
;uart_int_lib.h,34 :: 		if(udata==8 && uart1_data_pointer>0)
	MOV	#lo_addr(_udata), W0
	MOV.B	[W0], W0
	CP.B	W0, #8
	BRA Z	L__UART1INT1090
	GOTO	L__UART1INT844
L__UART1INT1090:
	MOV	#lo_addr(_uart1_data_pointer), W0
	MOV.B	[W0], W0
	CP.B	W0, #0
	BRA GT	L__UART1INT1091
	GOTO	L__UART1INT843
L__UART1INT1091:
L__UART1INT842:
;uart_int_lib.h,36 :: 		uart1_data_pointer--;
	MOV.B	#1, W1
	MOV	#lo_addr(_uart1_data_pointer), W0
	SUBR.B	W1, [W0], [W0]
;uart_int_lib.h,37 :: 		}
	GOTO	L_UART1INT70
;uart_int_lib.h,34 :: 		if(udata==8 && uart1_data_pointer>0)
L__UART1INT844:
L__UART1INT843:
;uart_int_lib.h,38 :: 		else if(udata==13)
	MOV	#lo_addr(_udata), W0
	MOV.B	[W0], W0
	CP.B	W0, #13
	BRA Z	L__UART1INT1092
	GOTO	L_UART1INT71
L__UART1INT1092:
;uart_int_lib.h,40 :: 		uart1_data_received=1;
	MOV	#lo_addr(_uart1_data_received), W1
	MOV.B	#1, W0
	MOV.B	W0, [W1]
;uart_int_lib.h,41 :: 		}
	GOTO	L_UART1INT72
L_UART1INT71:
;uart_int_lib.h,42 :: 		else if(udata!=10)
	MOV	#lo_addr(_udata), W0
	MOV.B	[W0], W0
	CP.B	W0, #10
	BRA NZ	L__UART1INT1093
	GOTO	L_UART1INT73
L__UART1INT1093:
;uart_int_lib.h,44 :: 		uart1_data[uart1_data_pointer]=udata;
	MOV	#lo_addr(_uart1_data_pointer), W0
	SE	[W0], W1
	MOV	#lo_addr(_uart1_data), W0
	ADD	W0, W1, W1
	MOV	#lo_addr(_udata), W0
	MOV.B	[W0], [W1]
;uart_int_lib.h,45 :: 		uart1_data_pointer++;
	MOV.B	#1, W1
	MOV	#lo_addr(_uart1_data_pointer), W0
	ADD.B	W1, [W0], [W0]
;uart_int_lib.h,46 :: 		}
L_UART1INT73:
L_UART1INT72:
L_UART1INT70:
;uart_int_lib.h,47 :: 		}
	GOTO	L_UART1INT65
L_UART1INT66:
;uart_int_lib.h,48 :: 		if(uart1_data_pointer==48) clear_uart1();
	MOV	#lo_addr(_uart1_data_pointer), W0
	MOV.B	[W0], W1
	MOV.B	#48, W0
	CP.B	W1, W0
	BRA Z	L__UART1INT1094
	GOTO	L_UART1INT74
L__UART1INT1094:
	CALL	_clear_uart1
L_UART1INT74:
;uart_int_lib.h,50 :: 		U1RXIF_bit=0;
	BCLR	U1RXIF_bit, BitPos(U1RXIF_bit+0)
;uart_int_lib.h,51 :: 		}
L_end_UART1INT:
	POP	W10
	MOV	#26, W0
	REPEAT	#12
	POP	[W0--]
	POP	W0
	POP	RCOUNT
	POP	52
	RETFIE
; end of _UART1INT

_UART2INT:
	PUSH	52
	PUSH	RCOUNT
	PUSH	W0
	MOV	#2, W0
	REPEAT	#12
	PUSH	[W0++]

;uart_int_lib.h,53 :: 		void UART2INT() iv IVT_ADDR_U2RXINTERRUPT
;uart_int_lib.h,55 :: 		while(U2STAbits.URXDA)
	PUSH	W10
L_UART2INT75:
	BTSS	U2STAbits, #0
	GOTO	L_UART2INT76
;uart_int_lib.h,57 :: 		udata2=UART2_Read();
	CALL	_UART2_Read
	MOV	#lo_addr(_udata2), W1
	MOV.B	W0, [W1]
;uart_int_lib.h,58 :: 		if(debug_gsm) UART1_Write(udata2);
	MOV	#lo_addr(_debug_gsm), W0
	CP0.B	[W0]
	BRA NZ	L__UART2INT1096
	GOTO	L_UART2INT77
L__UART2INT1096:
	MOV	#lo_addr(_udata2), W0
	ZE	[W0], W10
	CALL	_UART1_Write
L_UART2INT77:
;uart_int_lib.h,59 :: 		if(!dis_int)
	MOV	#lo_addr(_dis_int), W0
	CP0.B	[W0]
	BRA Z	L__UART2INT1097
	GOTO	L_UART2INT78
L__UART2INT1097:
;uart_int_lib.h,61 :: 		if(udata2!=10)
	MOV	#lo_addr(_udata2), W0
	MOV.B	[W0], W0
	CP.B	W0, #10
	BRA NZ	L__UART2INT1098
	GOTO	L_UART2INT79
L__UART2INT1098:
;uart_int_lib.h,63 :: 		if(udata2!=13)
	MOV	#lo_addr(_udata2), W0
	MOV.B	[W0], W0
	CP.B	W0, #13
	BRA NZ	L__UART2INT1099
	GOTO	L_UART2INT80
L__UART2INT1099:
;uart_int_lib.h,65 :: 		uart2_data[uart2_data_pointer]=udata2;
	MOV	#lo_addr(_uart2_data_pointer), W0
	SE	[W0], W1
	MOV	#lo_addr(_uart2_data), W0
	ADD	W0, W1, W1
	MOV	#lo_addr(_udata2), W0
	MOV.B	[W0], [W1]
;uart_int_lib.h,66 :: 		uart2_data_pointer++;
	MOV.B	#1, W1
	MOV	#lo_addr(_uart2_data_pointer), W0
	ADD.B	W1, [W0], [W0]
;uart_int_lib.h,67 :: 		if(udata2=='>') sending_ready=1;
	MOV	#lo_addr(_udata2), W0
	MOV.B	[W0], W1
	MOV.B	#62, W0
	CP.B	W1, W0
	BRA Z	L__UART2INT1100
	GOTO	L_UART2INT81
L__UART2INT1100:
	MOV	#lo_addr(_sending_ready), W1
	MOV.B	#1, W0
	MOV.B	W0, [W1]
L_UART2INT81:
;uart_int_lib.h,68 :: 		}
	GOTO	L_UART2INT82
L_UART2INT80:
;uart_int_lib.h,69 :: 		else if(uart2_data_pointer>0)
	MOV	#lo_addr(_uart2_data_pointer), W0
	MOV.B	[W0], W0
	CP.B	W0, #0
	BRA GT	L__UART2INT1101
	GOTO	L_UART2INT83
L__UART2INT1101:
;uart_int_lib.h,80 :: 		uart2_data_received=1;
	MOV	#lo_addr(_uart2_data_received), W1
	MOV.B	#1, W0
	MOV.B	W0, [W1]
;uart_int_lib.h,81 :: 		}
L_UART2INT83:
L_UART2INT82:
;uart_int_lib.h,82 :: 		}
L_UART2INT79:
;uart_int_lib.h,83 :: 		if(uart2_data_pointer==47) uart2_data_pointer=0;
	MOV	#lo_addr(_uart2_data_pointer), W0
	MOV.B	[W0], W1
	MOV.B	#47, W0
	CP.B	W1, W0
	BRA Z	L__UART2INT1102
	GOTO	L_UART2INT84
L__UART2INT1102:
	MOV	#lo_addr(_uart2_data_pointer), W1
	CLR	W0
	MOV.B	W0, [W1]
L_UART2INT84:
;uart_int_lib.h,84 :: 		}
L_UART2INT78:
;uart_int_lib.h,85 :: 		}
	GOTO	L_UART2INT75
L_UART2INT76:
;uart_int_lib.h,86 :: 		U2RXIF_bit=0;
	BCLR	U2RXIF_bit, BitPos(U2RXIF_bit+0)
;uart_int_lib.h,87 :: 		}
L_end_UART2INT:
	POP	W10
	MOV	#26, W0
	REPEAT	#12
	POP	[W0--]
	POP	W0
	POP	RCOUNT
	POP	52
	RETFIE
; end of _UART2INT

_distance_write:

;uart_int_lib.h,89 :: 		void distance_write()
;uart_int_lib.h,91 :: 		loop_distance=(uart1_data[6]-48)+(uart1_data[5]-48)*10+(uart1_data[4]-48)*100;
	PUSH	W10
	PUSH	W11
	PUSH	W12
	MOV	#lo_addr(_uart1_data+6), W0
	ZE	[W0], W1
	MOV	#48, W0
	SUB	W1, W0, W2
	MOV	#lo_addr(_uart1_data+5), W0
	ZE	[W0], W1
	MOV	#48, W0
	SUB	W1, W0, W1
	MOV	#10, W0
	MUL.SS	W1, W0, W0
	ADD	W2, W0, W2
	MOV	#lo_addr(_uart1_data+4), W0
	ZE	[W0], W1
	MOV	#48, W0
	SUB	W1, W0, W1
	MOV	#100, W0
	MUL.SS	W1, W0, W0
	ADD	W2, W0, W0
	MOV	W0, _loop_distance
;uart_int_lib.h,92 :: 		eeprom_write(0x7FFC18,loop_distance);
	MOV	W0, W12
	MOV	#64536, W10
	MOV	#127, W11
	CALL	_EEPROM_Write
;uart_int_lib.h,93 :: 		delay_ms(5);
	MOV	#24573, W7
L_distance_write85:
	DEC	W7
	BRA NZ	L_distance_write85
	NOP
;uart_int_lib.h,94 :: 		NVMADR=0xFF00;
	MOV	#65280, W0
	MOV	WREG, NVMADR
;uart_int_lib.h,95 :: 		NVMADRU=0x007F;
	MOV	#127, W0
	MOV	WREG, NVMADRU
;uart_int_lib.h,96 :: 		}
L_end_distance_write:
	POP	W12
	POP	W11
	POP	W10
	RETURN
; end of _distance_write

_looplen_write:

;uart_int_lib.h,97 :: 		void looplen_write()
;uart_int_lib.h,99 :: 		loop_width=(uart1_data[6]-48)+(uart1_data[5]-48)*10+(uart1_data[4]-48)*100;
	PUSH	W10
	PUSH	W11
	PUSH	W12
	MOV	#lo_addr(_uart1_data+6), W0
	ZE	[W0], W1
	MOV	#48, W0
	SUB	W1, W0, W2
	MOV	#lo_addr(_uart1_data+5), W0
	ZE	[W0], W1
	MOV	#48, W0
	SUB	W1, W0, W1
	MOV	#10, W0
	MUL.SS	W1, W0, W0
	ADD	W2, W0, W2
	MOV	#lo_addr(_uart1_data+4), W0
	ZE	[W0], W1
	MOV	#48, W0
	SUB	W1, W0, W1
	MOV	#100, W0
	MUL.SS	W1, W0, W0
	ADD	W2, W0, W0
	MOV	W0, _loop_width
;uart_int_lib.h,100 :: 		eeprom_write(0x7FFC1C,loop_width);
	MOV	W0, W12
	MOV	#64540, W10
	MOV	#127, W11
	CALL	_EEPROM_Write
;uart_int_lib.h,101 :: 		delay_ms(5);
	MOV	#24573, W7
L_looplen_write87:
	DEC	W7
	BRA NZ	L_looplen_write87
	NOP
;uart_int_lib.h,102 :: 		NVMADR=0xFF00;
	MOV	#65280, W0
	MOV	WREG, NVMADR
;uart_int_lib.h,103 :: 		NVMADRU=0x007F;
	MOV	#127, W0
	MOV	WREG, NVMADRU
;uart_int_lib.h,104 :: 		}
L_end_looplen_write:
	POP	W12
	POP	W11
	POP	W10
	RETURN
; end of _looplen_write

_margin_write:

;uart_int_lib.h,105 :: 		void margin_write()
;uart_int_lib.h,107 :: 		MARGINTOP=(uart1_data[5]-48)+(uart1_data[4]-48)*10;
	PUSH	W10
	PUSH	W11
	PUSH	W12
	MOV	#lo_addr(_uart1_data+5), W0
	ZE	[W0], W1
	MOV	#48, W0
	SUB	W1, W0, W2
	MOV	#lo_addr(_uart1_data+4), W0
	ZE	[W0], W1
	MOV	#48, W0
	SUB	W1, W0, W1
	MOV	#10, W0
	MUL.SS	W1, W0, W0
	ADD	W2, W0, W0
	MOV	W0, _MARGINTOP
;uart_int_lib.h,108 :: 		eeprom_write(0x7FFC00,MARGINTOP);
	MOV	W0, W12
	MOV	#64512, W10
	MOV	#127, W11
	CALL	_EEPROM_Write
;uart_int_lib.h,109 :: 		delay_ms(5);
	MOV	#24573, W7
L_margin_write89:
	DEC	W7
	BRA NZ	L_margin_write89
	NOP
;uart_int_lib.h,110 :: 		MARGINBOT=(uart1_data[7]-48)+(uart1_data[6]-48)*10;
	MOV	#lo_addr(_uart1_data+7), W0
	ZE	[W0], W1
	MOV	#48, W0
	SUB	W1, W0, W2
	MOV	#lo_addr(_uart1_data+6), W0
	ZE	[W0], W1
	MOV	#48, W0
	SUB	W1, W0, W1
	MOV	#10, W0
	MUL.SS	W1, W0, W0
	ADD	W2, W0, W0
	MOV	W0, _MARGINBOT
;uart_int_lib.h,111 :: 		eeprom_write(0x7FFC04,MARGINBOT);
	MOV	W0, W12
	MOV	#64516, W10
	MOV	#127, W11
	CALL	_EEPROM_Write
;uart_int_lib.h,112 :: 		delay_ms(5);
	MOV	#24573, W7
L_margin_write91:
	DEC	W7
	BRA NZ	L_margin_write91
	NOP
;uart_int_lib.h,113 :: 		NVMADR=0xFF00;
	MOV	#65280, W0
	MOV	WREG, NVMADR
;uart_int_lib.h,114 :: 		NVMADRU=0x007F;
	MOV	#127, W0
	MOV	WREG, NVMADRU
;uart_int_lib.h,115 :: 		}
L_end_margin_write:
	POP	W12
	POP	W11
	POP	W10
	RETURN
; end of _margin_write

_process_interface:
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
