sad-zz/Intelligent-Vehicle-Traffic-Monitoring-System/firmware/Main/Interval.h

void reset_interval_data()
{
     for(jj=0;jj<262;jj++) interval_data[jj]='0';
     for(jj=0;jj<8;jj++) interval_data[jj]=system_id[jj];
     interval_data[262]=13;
     interval_data[263]=10;
     interval_data[264]=0;
}
void reset_interval()
{
     current_interval.l1acount=0;
     current_interval.l1avavg=0;
     current_interval.l1aspeed=0;
     current_interval.l1agrab=0;
     current_interval.l1aheadway=0;
     
     current_interval.l1bcount=0;
     current_interval.l1bvavg=0;
     current_interval.l1bspeed=0;
     current_interval.l1bgrab=0;
     current_interval.l1bheadway=0;
     
     current_interval.l1ccount=0;
     current_interval.l1cvavg=0;
     current_interval.l1cspeed=0;
     current_interval.l1cgrab=0;
     current_interval.l1cheadway=0;
     
     current_interval.l1dcount=0;
     current_interval.l1dvavg=0;
     current_interval.l1dspeed=0;
     current_interval.l1dgrab=0;
     current_interval.l1dheadway=0;
     
     current_interval.l1ecount=0;
     current_interval.l1evavg=0;
     current_interval.l1espeed=0;
     current_interval.l1egrab=0;
     current_interval.l1eheadway=0;
     
     current_interval.l1xcount=0;
     current_interval.l1xvavg=0;
     current_interval.l1xspeed=0;
     current_interval.l1xgrab=0;
     current_interval.l1xheadway=0;
     
     current_interval.l2acount=0;
     current_interval.l2avavg=0;
     current_interval.l2aspeed=0;
     current_interval.l2agrab=0;
     current_interval.l2aheadway=0;

     current_interval.l2bcount=0;
     current_interval.l2bvavg=0;
     current_interval.l2bspeed=0;
     current_interval.l2bgrab=0;
     current_interval.l2bheadway=0;

     current_interval.l2ccount=0;
     current_interval.l2cvavg=0;
     current_interval.l2cvavgnew=0;
     current_interval.l2cspeed=0;
     current_interval.l2cgrab=0;
     current_interval.l2cheadway=0;

     current_interval.l2dcount=0;
     current_interval.l2dvavg=0;
     current_interval.l2dspeed=0;
     current_interval.l2dgrab=0;
     current_interval.l2dheadway=0;

     current_interval.l2ecount=0;
     current_interval.l2evavg=0;
     current_interval.l2espeed=0;
     current_interval.l2egrab=0;
     current_interval.l2eheadway=0;

     current_interval.l2xcount=0;
     current_interval.l2xvavg=0;
     current_interval.l2xspeed=0;
     current_interval.l2xgrab=0;
     current_interval.l2xheadway=0;


     totalv1a=0;
     totalv1b=0;
     totalv1c=0;
     totalv1d=0;
     totalv1e=0;
     totalv1x=0;
     totalv2a=0;
     totalv2b=0;
     totalv2c=0;
     //totalv2cnew=0;
     totalv2d=0;
     totalv2e=0;
     totalv2x=0;

     l1occ=0;
     l2occ=0;
    // #endif
}
void cal_interval()
{
     reset_interval_data();
     
     if(current_interval.l1acount>0) current_interval.l1avavg=(unsigned short)(totalv1a/current_interval.l1acount);
     else  current_interval.l1avavg=0;
     
     if(current_interval.l1bcount>0) current_interval.l1bvavg=(unsigned short)(totalv1b/current_interval.l1bcount);
     else  current_interval.l1bvavg=0;
     
     if(current_interval.l1ccount>0) current_interval.l1cvavg=(unsigned short)(totalv1c/current_interval.l1ccount);
     else  current_interval.l1cvavg=0;
     
     if(current_interval.l1dcount>0) current_interval.l1dvavg=(unsigned short)(totalv1d/current_interval.l1dcount);
     else  current_interval.l1dvavg=0;
     
     if(current_interval.l1ecount>0) current_interval.l1evavg=(unsigned short)(totalv1e/current_interval.l1ecount);
     else  current_interval.l1evavg=0;
     
     if(current_interval.l1xcount>0) current_interval.l1xvavg=(unsigned short)(totalv1x/current_interval.l1xcount);
     else  current_interval.l1xvavg=0;

     if(current_interval.l2acount>0) current_interval.l2avavg=(unsigned short)(totalv2a/current_interval.l2acount);
     else  current_interval.l2avavg=0;

     if(current_interval.l2bcount>0) current_interval.l2bvavg=(unsigned short)(totalv2b/current_interval.l2bcount);
     else  current_interval.l2bvavg=0;

     if(current_interval.l2ccount>0) current_interval.l2cvavg=(unsigned short)(totalv2c/(unsigned long)(current_interval.l2ccount));
     else  current_interval.l2cvavg=0;

     if(current_interval.l2dcount>0) current_interval.l2dvavg=(unsigned short)(totalv2d/current_interval.l2dcount);
     else  current_interval.l2dvavg=0;

     if(current_interval.l2ecount>0) current_interval.l2evavg=(unsigned short)(totalv2e/current_interval.l2ecount);
     else  current_interval.l2evavg=0;

     if(current_interval.l2xcount>0) current_interval.l2xvavg=(unsigned short)(totalv2x/current_interval.l2xcount);
     else  current_interval.l2xvavg=0;
     
     bytetostr(current_time.year,tmp3);
     interval_data[8]=tmp3[1];
     interval_data[9]=tmp3[2];
     bytetostr(current_time.month,tmp3);
     interval_data[10]=tmp3[1];
     interval_data[11]=tmp3[2];
     bytetostr(current_time.day,tmp3);
     interval_data[12]=tmp3[1];
     interval_data[13]=tmp3[2];
     bytetostr(current_time.hour,tmp3);
     interval_data[14]=tmp3[1];
     interval_data[15]=tmp3[2];
     bytetostr(current_time.minute,tmp3);
     interval_data[16]=tmp3[1];
     interval_data[17]=tmp3[2];
     //////////////////////////
     inttostr(current_interval.l1acount,tmp4);
     interval_data[18]=tmp4[2];
     interval_data[19]=tmp4[3];
     interval_data[20]=tmp4[4];
     interval_data[21]=tmp4[5];
     
     bytetostr(current_interval.l1avavg,tmp3);
     interval_data[22]=tmp3[0];
     interval_data[23]=tmp3[1];
     interval_data[24]=tmp3[2];
     
     inttostr(current_interval.l1aspeed,tmp4);
     interval_data[25]=tmp4[2];
     interval_data[26]=tmp4[3];
     interval_data[27]=tmp4[4];
     interval_data[28]=tmp4[5];

     inttostr(current_interval.l1agrab,tmp4);
     interval_data[29]=tmp4[2];
     interval_data[30]=tmp4[3];
     interval_data[31]=tmp4[4];
     interval_data[32]=tmp4[5];

     inttostr(current_interval.l1aheadway,tmp4);
     interval_data[33]=tmp4[2];
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
     interval_data[242]=tmp4[3];
     interval_data[243]=tmp4[4];
     interval_data[244]=tmp4[5];

     inttostr(current_interval.l2xheadway,tmp4);
     interval_data[245]=tmp4[2];
     interval_data[246]=tmp4[3];
     interval_data[247]=tmp4[4];
     interval_data[248]=tmp4[5];


     inttostr((int)(l2occ/(INTERVALPERIOD*2*600)),debug_txt);
     interval_data[249]=debug_txt[3];
     interval_data[250]=debug_txt[4];
     interval_data[251]=debug_txt[5];
     
     
     inttostr((int)(vbat*0.388509+7),debug_txt);
     interval_data[252]=debug_txt[3];
     interval_data[253]=debug_txt[4];
     interval_data[254]=debug_txt[5];
     
     if(solar<50)
     inttostr(0,debug_txt);
     else
     inttostr((int)(solar*0.388509),debug_txt);
     interval_data[255]=debug_txt[3];
     interval_data[256]=debug_txt[4];
     interval_data[257]=debug_txt[5];
     //temp=((long)(ADC1_Get_Sample(2)*488));
     //temp/=1000;
     inttostr(error_byte,debug_txt);
     interval_data[258]=debug_txt[2];
     interval_data[259]=debug_txt[3];
     interval_data[260]=debug_txt[4];
     interval_data[261]=debug_txt[5];

     //#endif
     //UART1_Write('4');
     reset_interval();
     //UART1_Write('4');
     for(cal_interval_cnt=0;cal_interval_cnt<262;cal_interval_cnt++) if(interval_data[cal_interval_cnt]==' ') interval_data[cal_interval_cnt]='0';
}
