sad-zz/Intelligent-Vehicle-Traffic-Monitoring-System/firmware/Main/MMC.h

void spifat_init()
{
    SPI1_Init_Advanced(_SPI_MASTER, _SPI_8_BIT, _SPI_PRESCALE_SEC_1, _SPI_PRESCALE_PRI_64,_SPI_SS_DISABLE, _SPI_DATA_SAMPLE_MIDDLE, _SPI_CLK_IDLE_LOW, _SPI_IDLE_2_ACTIVE);
    if(0==Mmc_Init())
    {
        memory_error=0;
    }
    else
    {
        delay_ms(1);
        if(0==Mmc_Init())
        {
            memory_error=0;
        }
        else
        {
            memory_error=1;
        }
        SPI1_read(0);
        SPI1_read(0);
    }
    //SPI1STAT.SPIEN=0;
    SPI1_Init_Advanced(_SPI_MASTER, _SPI_8_BIT, _SPI_PRESCALE_SEC_1, _SPI_PRESCALE_PRI_4,_SPI_SS_DISABLE, _SPI_DATA_SAMPLE_MIDDLE, _SPI_CLK_IDLE_HIGH, _SPI_ACTIVE_2_IDLE); //SPI1_Init_Advanced(_SPI_MASTER, _SPI_8_BIT, _SPI_PRESCALE_SEC_4, _SPI_PRESCALE_PRI_64,_SPI_SS_DISABLE, _SPI_DATA_SAMPLE_MIDDLE, _SPI_CLK_IDLE_HIGH, _SPI_ACTIVE_2_IDLE);
    SPI1_Write(0xFF);
}
