sad-zz/Intelligent-Vehicle-Traffic-Monitoring-System/(commit log)

2025-12-12 feat: Implement complete Vehicle Traffic Monitoring System
    Major Features:
    - STM32F407 firmware with inductive loop sensor drivers
    - Vehicle detection and classification (6 classes: X,A,B,C,D,E)
    - SIM800L GPRS driver for data transmission
    - Flask backend server with TCP receiver and REST API
    - PostgreSQL database schema with device monitoring
    - Real-time web dashboard with live updates
    - Automatic faulty device detection system
    - Temperature and humidity sensor integration
    - Watchdog and power management
    - Serial console interface
    Components:
    - firmware_stm32/: Complete STM32F407 firmware
    - Inductive loop sensor driver (4 channels)
    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
2025-12-12 docs: Add reference PIC firmware for comparison
    Add original PIC microcontroller firmware files as reference:
    - Original traffic counter implementation
    - Sensor reading algorithms
    - GPRS communication code
    - Vehicle classification logic
    These files serve as reference for understanding the original
    system behavior and algorithm implementation.
    [91-7.cfg]
2025-12-12 docs: Add comprehensive hardware setup and deployment guides
    Add detailed guides for hardware deployment and testing:
    1. STM32_SETUP_GUIDE.md - Complete STM32F407 setup guide:
    - STM32CubeMX pin configuration for EWB-STM32F407V-LAN-V4.0
    - Peripheral setup (UART, TIM, ADC, SDIO, RTC, IWDG)
    - Clock configuration (168MHz system clock)
    - DMA and NVIC configuration
    - Project generation for Keil and STM32CubeIDE
    - Build and upload instructions
    - Serial console commands
    - Calibration procedures
    - Troubleshooting guide
    2. SERVER_HARDWARE_REQUIREMENTS.md - Server infrastructure guide:
    - Hardware requirements for 50/100/200 devices
    - CPU, RAM, storage calculations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
2025-12-13 feat: Add ready-to-use STM32CubeMX project file (.ioc)
    - Complete pin configuration for EWB-STM32F407-V4 board
    - Clock tree configured for 168MHz from 25MHz HSE
    - All peripherals configured: UART1/2, TIM2/4, ADC1, SDIO, RTC, IWDG, I2C1
    - Ready to open in STM32CubeMX and generate code for Keil or STM32CubeIDE
    - Matches pin assignments from STM32_SETUP_GUIDE.md
2025-12-13 fix: Add complete application code and setup instructions
    - Create main.c with full vehicle detection logic
    - Add FIRMWARE_BUILD_GUIDE.md with step-by-step build instructions
    - Include automated setup scripts for Linux (setup_project.sh) and Windows (setup_project.bat)
    - Scripts automatically copy BSP drivers and Middleware to generated CubeMX project
    - Resolves compilation error: sensor_driver.h not found
    - Includes serial console interface with commands: help, status, calibrate, send, reset
    - Implements 10-minute data transmission cycle with JSON payload
    - Battery voltage monitoring and environmental sensors
    - Complete integration with SIM800L GPRS module
    - Watchdog refresh in main loop fo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
2025-12-14 fix: Resolve compilation errors in main.c
    - Add MAX_VEHICLES_PER_INTERVAL definition to config.h
    - Fix VehicleDetection_Callback signature to match header (remove lane parameter)
    - Fix SIM800L_Init to include config parameter
    - Fix VehicleDetection_Init to take no parameters
    - Change SIM800L_SendTCP to correct function name SIM800L_SendJSON
    - Use IntervalStats_t from vehicle detection instead of manual buffers
    - Remove unused lane1_buffer and lane2_buffer arrays
    - Add SIM800L_Config_t initialization with default values
    - Improve callback to show vehicle violations (speed, direction, headway)
    All compilation errors resolved. Code now matches BSP driver APIs.
    [config.h]
2025-12-14 fix: Add missing BSP and Middleware implementations
    - Fix multiple definition errors by changing peripheral handles to extern in main.c
    - Add complete SIM800L driver implementation (sim800l_driver.c)
    * AT command interface for GSM/GPRS communication
    * GPRS context setup and TCP connection
    * JSON data transmission to server
    * Signal quality monitoring
    * Power management functions
    - Add complete vehicle detection implementation (vehicle_detection.c)
    * Dual-loop sensor processing for 2 lanes
    * Vehicle speed and length calculation
    * 6-class vehicle classification (X,A,B,C,D,E)
    * Direction detection (forward/backward)
    * Violation detection (speed, direction, headway)
    * Inter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
2025-12-23 fix: Add TIM configuration and complete middleware implementation
    - Add tim.c with htim2 and htim4 definitions
    - Add tim.h with timer handle declarations
    - Add stdlib.h include to sim800l_driver.c (fix atoi warning)
    - Ensure vehicle_detection.c and all dependencies are available
    Resolves:
    - undefined reference to htim2
    - undefined reference to VehicleDetection_* functions
    - implicit declaration of atoi warning
    All linker errors should now be resolved.
2025-12-26 fix: Remove unused variables and add default case in vehicle_detection.c
    - Remove unused 'gap_time' variable in LANE_STATE_COMPLETE case
    - Remove unused 'start' variable in VehicleDetection_ResetInterval()
    - Add default case to switch statement to handle LANE_STATE_SECOND_LOOP_EXIT
    This eliminates all 3 compilation warnings for cleaner build output.
2025-12-29 feat: Add testing mode to skip SIM800L initialization
    - Skip SIM800L_Init() during system startup for sensor testing
    - Skip SIM800L_SendJSON() but still print JSON payload
    - Add informative messages about testing mode
    - Allows testing sensors and vehicle detection without GSM module
    This enables testing the core functionality while troubleshooting SIM800L separately.
2026-01-05 fix: Define hiwdg instead of extern to prevent reset loop
    - Change hiwdg from extern declaration to actual definition
    - Fixes continuous reset issue caused by undefined reference
    - System was crashing when trying to refresh watchdog timer
    This resolves the reset loop that prevented user interaction.
2026-06-07 hardware: add fixed KiCad schematic ready for PCB conversion
    - Replace 121 Altium-imported power symbols with standard KiCad power:GND/VCC/etc
    - Fix duplicate U50 reference designators (renamed to U92-U94)
    - Replace SIM900 with SIM800A (lib_id + footprint RF_GSM:SIMCom_SIM800)
    - Add 6 PWR_FLAG instances to prevent ERC power-pin-not-driven errors
    - Add missing power net lib symbol definitions (+12V, +3.3V, +VSOL, +BATT)
    - All placed symbols now have matching lib_symbols definitions
    - All key components have footprints assigned
    https://claude.ai/code/session_01A9HsvNeuoFeWKhVBvcw39T
    [sadegh_pcb_ready.kicad_sch]
2026-06-07 hardware: fix invalid symbol unit name prefixes for KiCad 10
    Remove .IntLib and .SchLib suffixes from all lib_symbols names and
    their sub-unit definitions (e.g. root_0_SIM900_SIM900.SchLib_1_0 →
    root_0_SIM900_SIM900_1_0). KiCad 10 rejects dots in symbol unit name
    prefixes. Also update all placed symbol lib_id references to match.
    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
    [sadegh_pcb_ready.kicad_sch]
2026-06-07 hardware: fix SIM800A sub-symbol unit name mismatch
    KiCad 10 requires sub-symbol unit names to start with the parent
    symbol name. After renaming SIM900→SIM800A, the sub-unit
    root_0_SIM900_SIM900_1_0 was still using the old name.
    Renamed to root_0_SIM800A_SIM800A_1_0 to match parent.
    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
    [sadegh_pcb_ready.kicad_sch]
2026-06-07 hardware: remove AMS1117, DHT11, and MMC from schematic
    Per design requirements:
    - Remove AMS1117CD-3.3 voltage regulator (not needed)
    - Remove DHT11 temperature/humidity sensor
    - Remove MMC/SD card module (replaced by W25Q32 SPI flash)
    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
    [sadegh_pcb_ready.kicad_sch]
2026-06-07 hardware: fix lib_name sub-unit references after SchLib/IntLib rename
    The previous commit fixed sub-unit names in lib_symbols by removing
    .IntLib and .SchLib suffixes, but placed symbol instances still referenced
    the old names via (lib_name ...) fields. This mismatch would cause KiCad
    to fail resolving symbol geometry for capacitors and inductors.
    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
    [sadegh_pcb_ready.kicad_sch]
2026-06-07 hardware: fix power symbol definitions embedded inside bus_entry block
    Duplicate power symbol definitions (power:+3.3V, +BATT, +12V, +VSOL)
    were incorrectly nested inside a bus_entry element instead of in
    lib_symbols, causing KiCad to fail parsing at line 13246.
    These duplicates are already present in lib_symbols; removed them
    from bus_entry so it closes properly after its uuid field.
    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
    [sadegh_pcb_ready.kicad_sch]
2026-06-07 hardware: fix all footprints to correct THT/DIP packages
    Replace SMD/incorrect footprints from Altium import with correct
    through-hole (THT) packages matching the actual components used:
    - dsPIC30F4011: DIP-40 (was TQFP-44)
    - 2N3904: TO-92 THT (was SOT-23 SMD)
    - IRF9540N: TO-220-3 THT (was SOT-23 SMD)
    - LM339: DIP-14 THT (was SOIC-14 SMD)
    - HCF4051: DIP-16 THT (was SOIC-16 SMD)
    - LM2576: TO-220-5 THT (was TO-263 SMD)
    - Resistors: axial THT (was 0805 SMD)
    - Capacitors: disc/radial THT (was 0805 SMD)
    - Diodes: DO-41 THT (was SMA SMD)
    - Connectors: 2.54mm pin header THT (was 1mm SMD)
    - SMD kept for: W25Q32, FT232RL, SIM800A (no THT alternatives)
    https://claude.ai/code/session_01A9HsvNeuoFeWKhV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
    [sadegh_pcb_ready.kicad_sch]
2026-06-07 hardware: fix ERC errors - convert hierarchical labels to global labels
    - Convert all 43 hierarchical_label to global_label (Altium import
    artifact; this is a flat single-sheet schematic with no hierarchy)
    - Remove orphaned labels for removed components: RTCCS (RTC removed),
    MMCINT and MMCCS (MMC removed)
    Fixes: "hierarchical label cannot be connected to non-existent parent
    sheet" errors in KiCad ERC.
    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
    [sadegh_pcb_ready.kicad_sch]
2026-06-07 hardware: fix 4 footprints to use available library variants
    - LM2576: TO-220-5_P3.4mm_Vertical -> TO-220-5_Vertical (available)
    - Inductor: L_Radial_D8.7mm_P5.00mm -> Fastron_07HCP variant (available)
    - SIM800A: SIMCom_SIM800 -> SIMCom_SIM800C (available in RF_GSM)
    - W25Q32: SOIC-8_5.3x5.3mm -> SOIC-8W_5.3x5.3mm (wide body, available)
    All 22 footprints now confirmed present in KiCad standard library.
    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
    [sadegh_pcb_ready.kicad_sch]
2026-06-07 hardware: add KiCad project file to enable PCB workflow
    Without sadegh_pcb_ready.kicad_pro, KiCad disables "Update PCB from
    Schematic" because it cannot link the schematic to a PCB file.
    The project file ties the .kicad_sch and future .kicad_pcb together.
    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
2026-06-07 hardware: convert all footprints to SMD and fix remaining PCB update errors
    - Convert all THT/DIP footprints to SMD equivalents:
    - Resistors: R_Axial → R_0805_2012Metric (38 parts)
    - Caps disc: C_Disc → C_0805_2012Metric (31 parts)
    - Caps electrolytic: CP_Radial → C_Tantalum_E_7.3x4.3mm (10 parts)
    - Transistors: TO-92 → SOT-23 (13 parts)
    - MOSFETs: TO-220-3 → TO-263-3_TabPin2 (4 parts)
    - LM2576: TO-220-5 → TO-263-5_TabPin6 (3 parts, tab=pin6)
    - DIP-14 → SOIC-14 (4 LM339)
    - DIP-16 → SOIC-16 (2 HCF4051)
    - DIP-40 dsPIC → TQFP-44_10x10mm (1 part)
    - Inductors: L_Radial → L_12x12mm_H8mm (3 parts)
    - W25Q32: SOIC-8W → SOIC-8_3.9x4.9mm_P1.27mm (2 parts)
    -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
    [sadegh_pcb_ready.kicad_sch]
2026-06-07 hardware: replace 2SJ196/BSS92 with SI2309DS, add Phoenix connectors, add ICSP header
    - Replace 2SJ196/BSS92 P-channel MOSFET with SI2309DS (SOT-23):
    - 4 instances updated (Value + Footprint)
    - Custom SOT-23_GDS footprint: pad2=Drain(physical pin3), pad3=Source(physical pin2)
    to match the schematic symbol pin assignment G=1, D=2, S=3
    - P1 (8-pin signal connector): PinHeader_1x08 → Phoenix Contact MSTB_2,5_8-GF-5,08
    (5.08mm pitch, accepts up to 2.5mm² wire, threaded flange for strain relief)
    - PW1 (4-pin power input): PinHeader_1x04 → Phoenix Contact MSTB_2,5_4-GF-5,08
    (5.08mm pitch, accepts 0.2-2.5mm² wire - suitable for 1-2mm² power wiring)
    - Add ICSP1 programming header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
    [sadegh_pcb_ready.kicad_sch]
2026-06-07 hardware: fix LM339J multi-unit reference - merge 4 ICs into 1
    The 4 LM339J comparator units were imported from Altium with separate
    references (U50, U92, U93, U94), causing 4 physical ICs to appear on
    the PCB instead of 1. All units are now under the same reference U50:
    U50 (unit 1) - Comparator 1: IN1+, IN1-, OUT1 (pins 4,5,2)
    U50 (unit 2) - Comparator 2: IN2+, IN2-, OUT2 (pins 6,7,1)
    U50 (unit 3) - Comparator 3: IN3+, IN3-, OUT3 (pins 8,9,14)
    U50 (unit 4) - Comparator 4: IN4+, IN4-, OUT4 (pins 10,11,13)
    Power pins V+ (pin 3) and GND (pin 12) are present in each unit
    instance per the Altium import convention. PCB will now show 1x
    SOIC-14 footprint instead of 4x.
    https://claude.a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
    [sadegh_pcb_ready.kicad_sch]
2026-06-07 hardware: add PCB net classes with trace widths for power vs signal
    Define 3 net classes in kicad_pro for automatic trace width assignment:
    Default (signal): 0.25mm trace, 0.8mm via
    - SPI, UART, GPIO, comparator outputs, etc.
    Power (3.3V logic supply): 0.8mm trace, 1.2mm via
    - +3.3V, VCC, GND nets
    HighPower (battery/solar/12V): 1.5mm trace, 1.6mm via
    - +BATT, +VSOL, +12V nets (up to ~2A through LM2576 regulators)
    Net class patterns auto-assign nets by name when PCB is updated.
    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
2026-06-08 Fix Tantalum capacitor footprint to use installed KiCad library
    Replace non-existent Capacitor_SMD:C_Tantalum_E_7.3x4.3mm_P4.10mm with
    Capacitor_Tantalum_SMD:CP_EIA-3528-21_Kemet-B (B-case 3.5x2.8mm Tantalum)
    for all 10 polarized capacitors (Cp71-75, Cp91-92, Cp101, C402, C404).
    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
    [sadegh_pcb_ready.kicad_sch]
2026-06-08 Add hardware_EC200U folder: 4G LTE variant with Quectel EC200U module
    New separate KiCad project for EC200U-based board variant:
    - EC200U_pcb.kicad_sch: schematic copied from SIM900 design as base
    - EC200U_pcb.kicad_pro: project file with RF net class added for antenna traces
    - custom_footprints.pretty/EC200U_LGA144.kicad_mod: 144-pad LGA footprint
    converted from official Quectel Altium library data
    - fp-lib-table: points to local custom_footprints.pretty
    Original hardware/ folder (SIM900 design) left untouched until board tested.
    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
    [EC200U_pcb.kicad_sch]
